TeoMouse/2P2S3B-Converter/README.md

# 2P2S3B-Converter
2 Phase, 2 Switch Bidirectional Buck Boost Converter
