TeoMouse/2P2S3B-Converter/3_ProductionFiles/1_ControllerBoard/BOM/Bill of Materials-F280025_Daughter_Board.xlsx

Line # | Name | Description | Designator | Quantity | Manufacturer | Value | Manufacturer Part No | Manufacturer 1 | Manufacturer Part Number 1
 | C0603 | Capacitor | C1, C6, C7, C8, C10 | 5 |  | 10uF/25V
 | C0402 | Capacitor | C2, C3, C4, C5, C9, C11, C12, C16, C17, C18, C21 | 11 |  | 100nF/50V
 | C0402 | Capacitor | C13 | 1 |  | 10nF/50V
 | C0402 | Capacitor | C14, C15 | 2 |  | 12pF/25V
 | C1206 | Capacitor | C22 | 1 |  | 2.2uF/100V
 | C0805 | Capacitor | C23, C24 | 2 |  | 22uF/25V
 | C0402 | Capacitor | C25, C26, C27, C28 | 4 |  | 1uF/25V
 | C0402 | Capacitor | C29, C30, C31, C32, C33, C34, C35, C36, C37, C38, C39, C40, C41, C42 | 14 |  | 1nF/25V
 | V | LED | D1, D2 | 2 |  |  |  | Wurth Electronics | 150060GS75000
 | 100Ohms |  | FB1, FB2 | 2 |  |  |  | Wurth Electronics | 742792620
 | 74404064680 | Inductor 68 uH 1A Wurth Elektronic | L2 | 1 |  |  |  | Wurth Electronics | 74404064680
 | 2x22_2mm_PCBCon |  | P1 | 1 |  |  |  | Samtec | FTS-122-01-F-D
 | R0402 | Resistor | R1, R2, R3, R4, R5, R6, R7, R8, R9, R10, R11, R13, R15, R16 | 14 |  | 100R
 | R0402 | Resistor | R12, R14 | 2 |  | 33R
 | R0402 | Resistor | R17, R24, R28 | 3 |  | 2.2k
 | R0402 | Resistor | R18, R19, R20, R21, R25, R26, R27, R30 | 8 |  | 10k
 | R0402 | Resistor | R22, R23 | 2 |  | 500R
 | R0402 | Resistor | R29 | 1 |  | 800R
 | R0805 | Resistor | R34 | 1 |  | 0R
 | R0402 | Resistor | R35 | 1 |  | 118k
 | R0402 | Resistor | R36 | 1 |  | 22.1k
 | SW2x2 | Tactile Switches SPST OFF-(ON) Round pushbutton | SW1 | 1 | TE Connectivity / Alcoswitch |  | FSM4JH
 | TMS320F280025C_LQFP48 |  | U1 | 1 |  |  |  | Texas Instruments | F280025CPTSR
 | 1x6 2.54mm St_Con_Fem |  | U2 | 1
 | TPS3702CX33DDCR |  | U3 | 1 |  |  |  | Texas Instruments | TPS3702CX33DDCR
 | LMR51610 |  | U5 | 1 |  |  |  | Texas Instruments | LMR51610XFDBVR
 | REF3030AIDBZR |  | U6 | 1 |  |  |  | Texas Instruments | REF3030AIDBZR
 | AP2112K-3.3TRG1 |  | U7 | 1 |  |  |  | Diodes | AP2112K-3.3TRG1
 | ECS-200-8-30B-CKM | 20MHz crystal oscillator | Y1 | 1 |  |  |  | ECS International | ECS-200-8-30B-CKM
