TeoMouse/2P2S3B-Converter/3_ProductionFiles/2_HBridgeBoard/BOM/Bill of Materials-HBridges_PB_V2.xlsx

Line # | Name | Description | Designator | Quantity | Manufacturer 1 | Manufacturer Part Number 1 | Manufacturer Lifecycle 1 | Supplier 1 | Supplier Part Number 1
 | C1206 | Capacitor | C2_1, C2_2, C3_1, C3_2 | 4 | Kyocera AVX | 12061C225KAT2A | Volume Production | Mouser | 581-12061C225KAT2A
 | C0603 | Capacitor | C4, C7 | 2
 | C0603 | Capacitor | C5, C6 | 2
 | C0402 | Capacitor | C8, C10, C11 | 3
 | C0402 | Capacitor | C9, C12, C13, C14, C15 | 5
 | Schottky | Schottky Diode | D5, D6 | 2 | ON Semiconductor / Fairchild | S110FA | Not Recommended for New Design | Mouser | 512-S110FA
 | Inductor 0603 | Magnetic-Core Inductor | L1, L2 | 2 | TDK | MLZ1608N100LTD25 | Volume Production | Mouser | 810-MLZ1608N100LTD25
 | 2Ph_HB_DB |  | P1 | 1
 | R0805 | Resistor | R1_1, R1_2, R2_1, R2_2, R3_1, R3_2, R4_1, R4_2 | 8
 | R0402 | Resistor | R5_1, R5_2, R6_1, R6_2, R11_1, R11_2, R12_1, R12_2, R17, R18, R19, R20 | 12
 | R0603 | Resistor | R7, R8 | 2 | Panasonic | ERT-J1VG103FM | Volume Production | Mouser | 667-ERT-J1VG103FM
 | R0603 | Resistor | R13, R14 | 2
 | R0402 | Resistor | R15, R16 | 2
 | TPH4R10ANL-L1Q | MOSFET N-Channel | U1_1, U1_2, U2_1, U2_2, U3_1, U3_2, U4_1, U4_2 | 8 | Toshiba | TPH4R10ANL,L1Q | Unknown | Mouser | 757-TPH4R10ANLL1Q
 | UCC21225 |  | U5, U6 | 2 | Texas Instruments | UCC21225ANPLR | Volume Production | Mouser | 595-UCC21225ANPLR
