TeoMouse/2P2S3B-Converter/3_ProductionFiles/3_MainBoard/BOM/Bill of Materials-2Ph_BuckBoost_Main.xlsx

Line # | Name | Description | Designator | Quantity | Manufacturer 1 | Manufacturer Part Number 1 | Manufacturer Lifecycle 1 | Supplier 1 | Supplier Part Number 1
 | 200uF/63V |  | C1 | 1
 | C1206 | Capacitor | C2, C3, C7, C8, C9, C10, C11, C12, C13, C14, C15, C16, C17, C18, C19, C20, C21, C22, C23, C24 | 20 | Kyocera AVX | 12061C225KAT2A | Volume Production | Mouser | 581-12061C225KAT2A
 | C0603 | Capacitor | C4 | 1
 | C0402 | Capacitor | C5 | 1
 | Cap_Bank 600uF 35V | Polarized Capacitor SMD | C6 | 1
 | C0402 | Capacitor | C25 | 1
 | C0402 | Capacitor | C26, C27, C28, C35_1, C35_2, C36_1, C36_2, C37, C38 | 9
 | C0805 | Capacitor | C29 | 1
 | C0805 | Capacitor | C30, C31 | 2
 | C0402 | Capacitor | C32, C33 | 2
 | C0402 | Capacitor | C34_1, C34_2 | 2
 | Schottky | Schottky Diode | D1, D2, D3 | 3 | ON Semiconductor / Fairchild | S110FA | Not Recommended for New Design | Mouser | 512-S110FA
 | WurthConnector_M3_FEM |  | J1, J2, J3, J4 | 4 | Wurth Electronics | 74650073R | Unknown | Mouser | 710-74650073R
 | Inductor TDK | Magnetic-Core Inductor | L1, L2 | 2 | TDK | B82559A0303A024 | Volume Production | Mouser | 871-B82559A0303A024
 | 74404064680 | Inductor 68 uH 1A Wurth Elektronic | L3 | 1 | Wurth Electronics | 74404064680 | Volume Production | Mouser | 710-74404064680
 | F280025_DB_Connector |  | P1 | 1
 | 2Ph_HB_DB |  | P2 | 1
 | 1x2 2.54mm Straight Con |  | P3 | 1
 | PMV450ENEAR | MOSFET (N-Channel) | Q1 | 1 | Nexperia | PMV450ENEAR | Volume Production | Mouser | 771-PMV450ENEAR
 | R0805 | Resistor | R1 | 1
 | R0603 | Resistor | R2 | 1
 | R0402 | Resistor | R3 | 1
 | R0402 | Resistor | R4, R10 | 2
 | R0603 | Resistor | R5, R6, R8, R9 | 4
 | R0402 | Resistor | R7, R14_1, R14_2 | 3
 | R0402 | Resistor | R11 | 1
 | R0402 | Resistor | R12 | 1
 | Rshunt | Resistor | R13_1, R13_2 | 2 | Bourns | CSS2H-2512R-1L00FE | Unknown | Mouser | 652-CSS2H2512R1L00FE
 | R0402 | Resistor | R15, R16, R17, R18 | 4
 | TLV9061 |  | U1 | 1 | Texas Instruments | TLV9061SQDBVRQ1 | Volume Production | Mouser | 595-TLV9061SQDBVRQ1
 | LMR51610 |  | U2 | 1 | Texas Instruments | LMR51610XFDBVR | Volume Production | Mouser | 595-LMR51610XFDBVR
 | ISL21010CFH315Z-TK |  | U3 | 1 | Intersil | ISL21010CFH315Z-TK | Volume Production | Mouser | 968-ISL21010CFH315ZT
 | INA296B3 |  | U4_1, U4_2 | 2 | Texas Instruments | INA296B4IDDFR | Volume Production | Mouser | 595-INA296B4IDDFR
