TeoMouse/2P2S3B-Converter/3_ProductionFiles/4_InputCapBoard/BOM/Bill of Materials-Cap_Board.xlsx

Line # | Name | Description | Designator | Quantity | Manufacturer 1 | Manufacturer Part Number 1 | Supplier 1 | Supplier Part Number 1
 | Cap_Pol 100uF 63V | Polarized Capacitor SMD | C1, C2 | 2 | Panasonic | EEE-FK1J101P | Mouser | 667-EEE-FK1J101P
 | 1x4 2.54mm St_Con_SMD |  | U1 | 1 | Amphenol Communications Solutions | 68000-204HLF | Mouser | 649-68000-204HLF
