TeoMouse/2P2S3B-Converter/3_ProductionFiles/5_OutputCapBoard/BOM/Bill of Materials-OutputCapBoard.xlsx

Line # | Name | Description | Designator | Quantity | Manufacturer 1 | Manufacturer Part Number 1 | Supplier 1 | Supplier Part Number 1
 | Cap_Pol 100uF 35V | Polarized Capacitor SMD | C1, C2, C3, C4, C5, C6 | 6 | Wurth Electronics | 865080545012 | Mouser | 710-865080545012
 | 1x3 2.54mm St_con |  | P1, P2 | 2 | Molex | 22-28-8032 | Mouser | 538-22-28-8032
