TeoMouse/2P2S3B-Converter/3_ProductionFiles/2_HBridgeBoard/ExportSTEP/HBridge_PCB.step

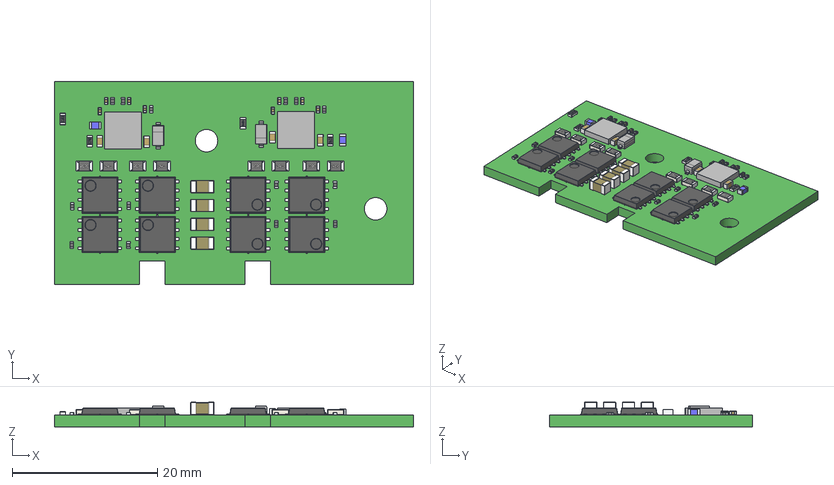
[picture p1: CAD file, 2025-03-23]
3_ProductionFiles/2_HBridgeBoard/ExportSTEP/HBridge_PCB.step
49.5 x 28.0 x 3.40 mm
Pin1Body x 4
Pin2Body x 4
CeramicBody x 4
CoatingBody x 4
Text1Body x 4
Text2Body x 4
Text3Body x 4
Text4Body x 4
User_Library-Vhip_cap_1206 x 4
Extruded x 2
TPH4R10ANL,L1Q x 8
term1 x 16
term2 x 16
User_Library-RES_2013-0805 x 8
CircuitWorks-SOD123_RGB8421504 x 2
User_Library-CAPC1608X09 x 4
