TeoMouse/2P2S3B-Converter/3_ProductionFiles/4_InputCapBoard/ExportSTEP/CapBoard.step

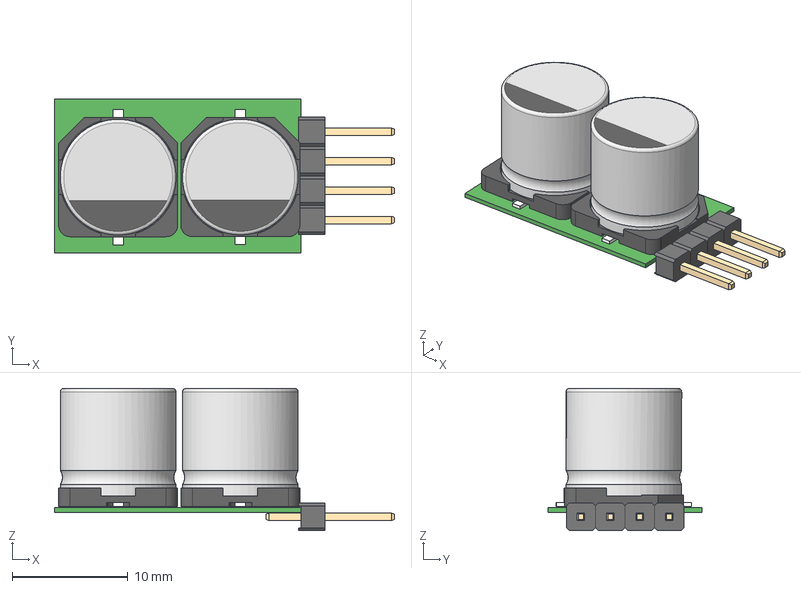
[picture p2: CAD file, 2025-03-23]
3_ProductionFiles/4_InputCapBoard/ExportSTEP/CapBoard.step
29.4 x 13.3 x 12.3 mm
1_Male_Pin_2.54_mm x 4
\X2\6A196E9654C130B130FC30B903A6\X0\10x9.3L_SIDE_CODE_G x 2
\X2\6A196E9654C15EA7724803A6\X0\10_SIZE_CODE_G x 2
\X2\6A196E9654C130EA30FC30C97DDA03A6\X0\10_SIZE_CODE_G x 4
