TeoMouse/2P2S3B-Converter/3_ProductionFiles/5_OutputCapBoard/ExportSTEP/CapsPCB.step

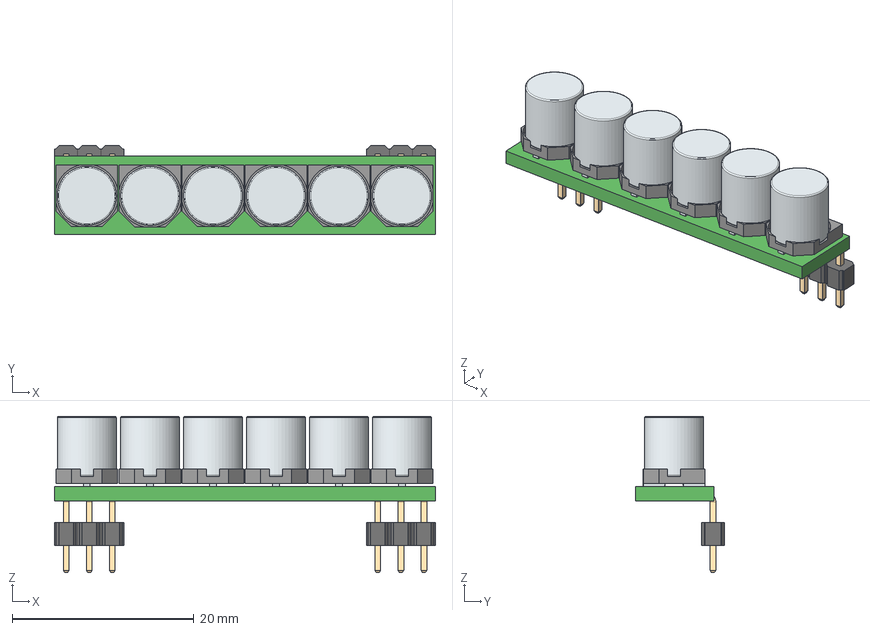
[picture p3: CAD file, 2025-03-23]
3_ProductionFiles/5_OutputCapBoard/ExportSTEP/CapsPCB.step
41.9 x 9.75 x 17.2 mm
DS1022-1x7RUF11_(1) x 2
Base x 6
Pin1Fillet x 6
Pin2Fillet x 6
