TeoMouse/2P2S3B-Converter/3_ProductionFiles/1_ControllerBoard/ExportSTEP/F280025_DB.step

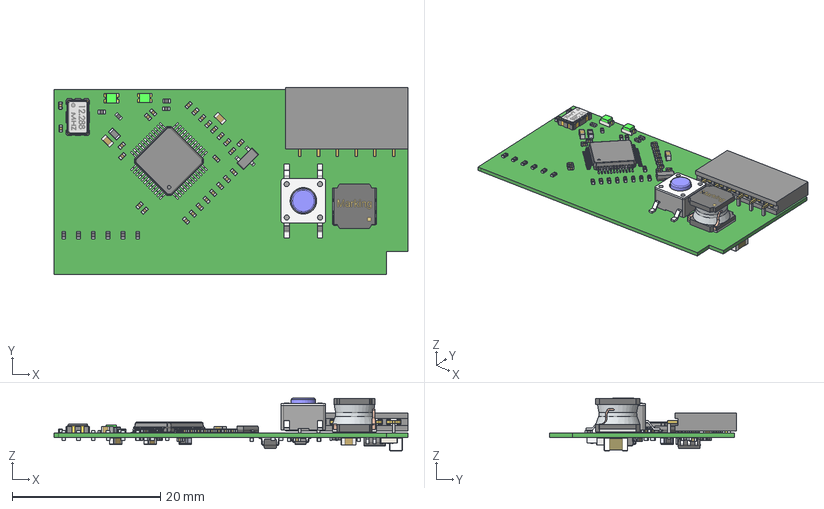
[picture p4: CAD file, 2025-03-23]
3_ProductionFiles/1_ControllerBoard/ExportSTEP/F280025_DB.step
47.8 x 25.3 x 7.09 mm
term1 x 32
term2 x 32
OSC5032
sot23-5_p0-95_l3-0_w1-7
DBZ0003A_2
DBZ0003A_1 x 3
SOT23-6
DDC0006A_2
DDC0006A_1 x 6
Pitch_x_8
Plastic_x_8
BODY_VBH48A
LEAD_VBH48A x 48
LL3301_SMT
TopPlate
Plunger
Pins
User_Library-RES_2013-0805
housing
contact x 2
spule
Glue
ferrite_bead_0603 x 2
everlight-17-21-0805LED-GREEN x 2
User_Library-CAPC2013X10 x 2
User_Library-Vhip_cap_1206
User_Library-CAPC1608X09 x 5
