TeoMouse/2P2S3B-Converter/(list of files, cad)

Other CAD files:
1_F280025_Firmware/1_BuckModeFirmware/CPU1_FLASH/main (1).obj
1_F280025_Firmware/1_BuckModeFirmware/CPU1_RAM/main.obj
1_F280025_Firmware/1_BuckModeFirmware/CPU1_RAM/control.obj
1_F280025_Firmware/1_BuckModeFirmware/CPU1_RAM/pwm.obj
1_F280025_Firmware/1_BuckModeFirmware/CPU1_FLASH/gpio_ex1_setup.obj
1_F280025_Firmware/1_BuckModeFirmware/CPU1_FLASH/adc.obj
1_F280025_Firmware/1_BuckModeFirmware/CPU1_RAM/adc.obj
1_F280025_Firmware/1_BuckModeFirmware/CPU1_FLASH/control.obj
1_F280025_Firmware/1_BuckModeFirmware/CPU1_FLASH/pwm.obj
1_F280025_Firmware/1_BuckModeFirmware/CPU1_FLASH/f28002x_globalvariabledefs.obj
1_F280025_Firmware/1_BuckModeFirmware/CPU1_RAM/f28002x_piectrl.obj
1_F280025_Firmware/1_BuckModeFirmware/CPU1_RAM/f28002x_epwm.obj
1_F280025_Firmware/1_BuckModeFirmware/CPU1_FLASH/f28002x_defaultisr.obj
1_F280025_Firmware/1_BuckModeFirmware/CPU1_FLASH/f28002x_sysctrl (1).obj
1_F280025_Firmware/1_BuckModeFirmware/CPU1_FLASH/f28002x_codestartbranch.obj
1_F280025_Firmware/1_BuckModeFirmware/CPU1_FLASH/f28002x_cputimers.obj
1_F280025_Firmware/1_BuckModeFirmware/CPU1_FLASH/f28002x_epwm.obj
1_F280025_Firmware/1_BuckModeFirmware/CPU1_FLASH/f28002x_gpio.obj
1_F280025_Firmware/1_BuckModeFirmware/CPU1_FLASH/f28002x_piectrl.obj
1_F280025_Firmware/1_BuckModeFirmware/CPU1_FLASH/f28002x_pievect.obj
1_F280025_Firmware/1_BuckModeFirmware/CPU1_FLASH/f28002x_usdelay.obj
1_F280025_Firmware/1_BuckModeFirmware/CPU1_RAM/adc (1).obj
1_F280025_Firmware/1_BuckModeFirmware/CPU1_RAM/adc (2).obj
1_F280025_Firmware/1_BuckModeFirmware/CPU1_RAM/control (2).obj
1_F280025_Firmware/1_BuckModeFirmware/CPU1_RAM/f28002x_codestartbranch.obj
1_F280025_Firmware/1_BuckModeFirmware/CPU1_RAM/f28002x_cputimers.obj
1_F280025_Firmware/1_BuckModeFirmware/CPU1_RAM/f28002x_defaultisr.obj
1_F280025_Firmware/1_BuckModeFirmware/CPU1_RAM/f28002x_globalvariabledefs.obj
1_F280025_Firmware/1_BuckModeFirmware/CPU1_RAM/f28002x_gpio.obj
1_F280025_Firmware/1_BuckModeFirmware/CPU1_RAM/f28002x_pievect.obj
1_F280025_Firmware/1_BuckModeFirmware/CPU1_RAM/f28002x_sysctrl.obj
1_F280025_Firmware/1_BuckModeFirmware/CPU1_RAM/f28002x_usdelay.obj
1_F280025_Firmware/1_BuckModeFirmware/CPU1_RAM/main (1).obj
1_F280025_Firmware/1_BuckModeFirmware/CPU1_RAM/pwm (2).obj
