TeoMouse/2P2S3B-Converter/2_Schematic_Documents/3_MainBoard/Schematics.PDF

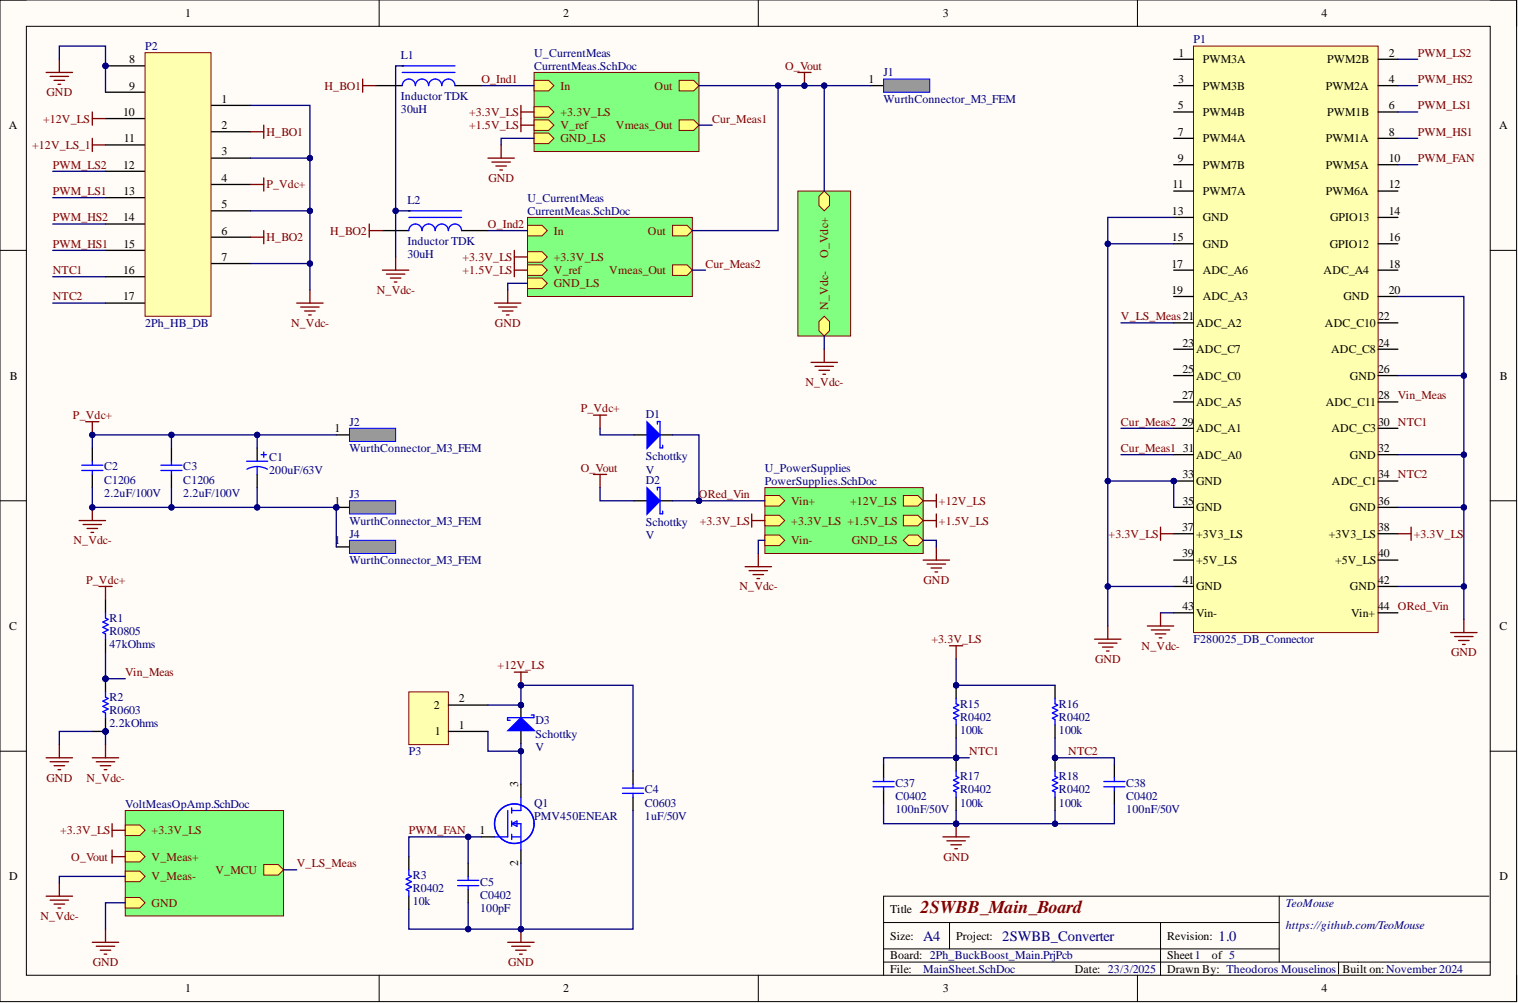
[picture p5: page 1]

4 3 | | 4 4 | ORed _ Vi n

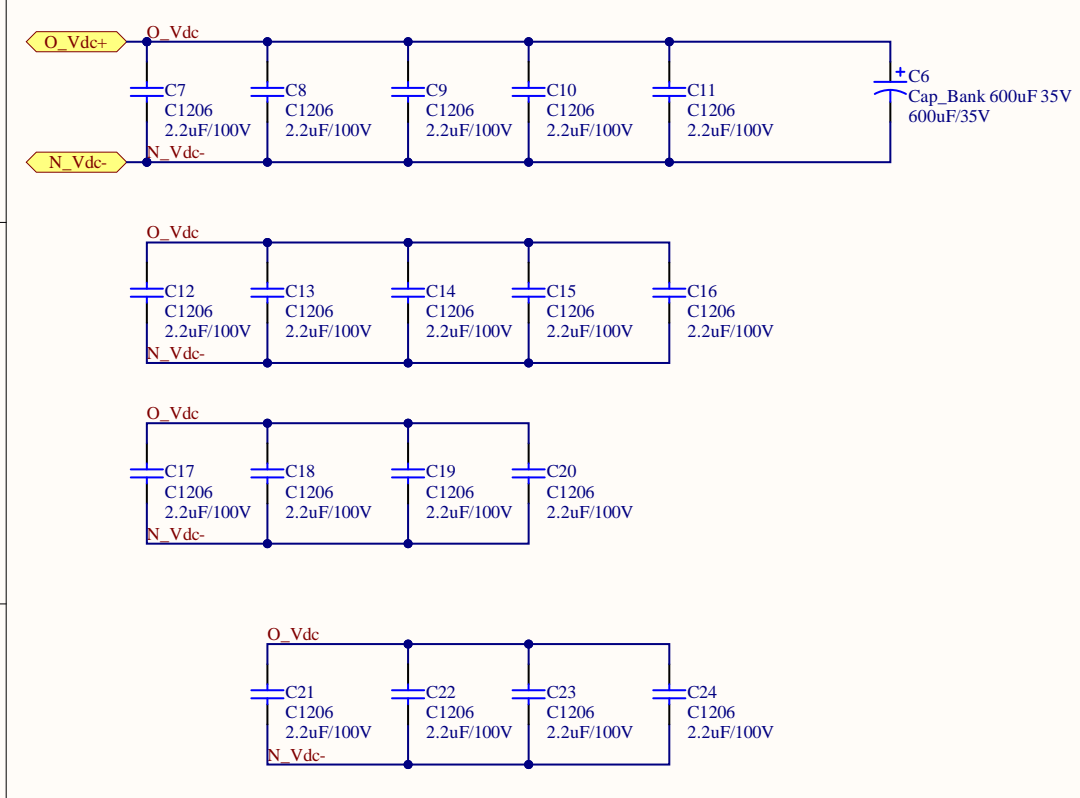
[picture p6: page 2]

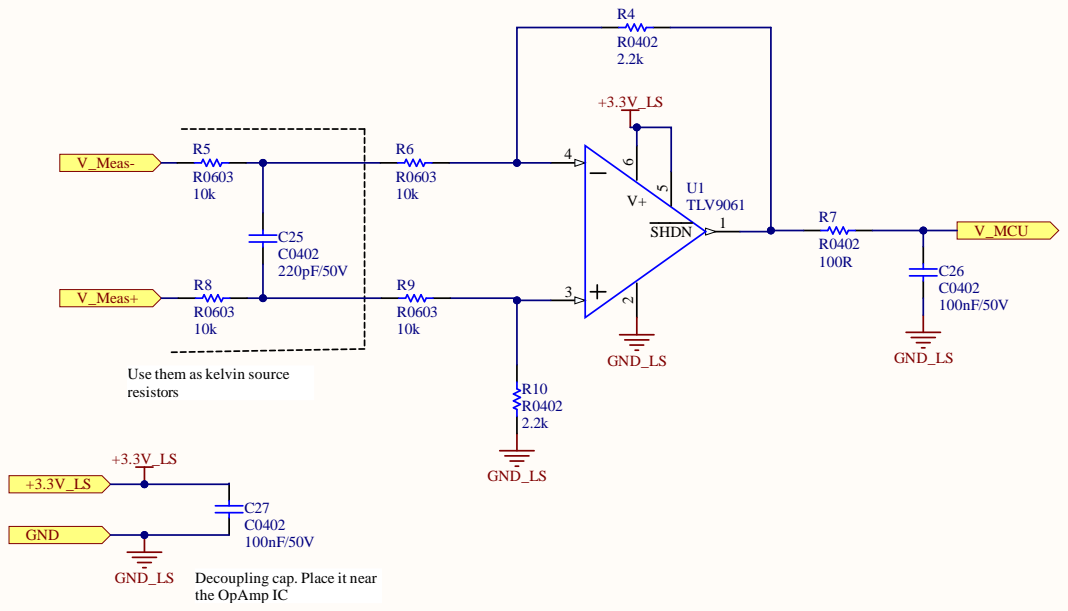
[picture p7: page 3]

Use them as kelvin source
resistors

Decoupling cap. Place it near
the OpAmp IC

https://github.com/TeoMouse

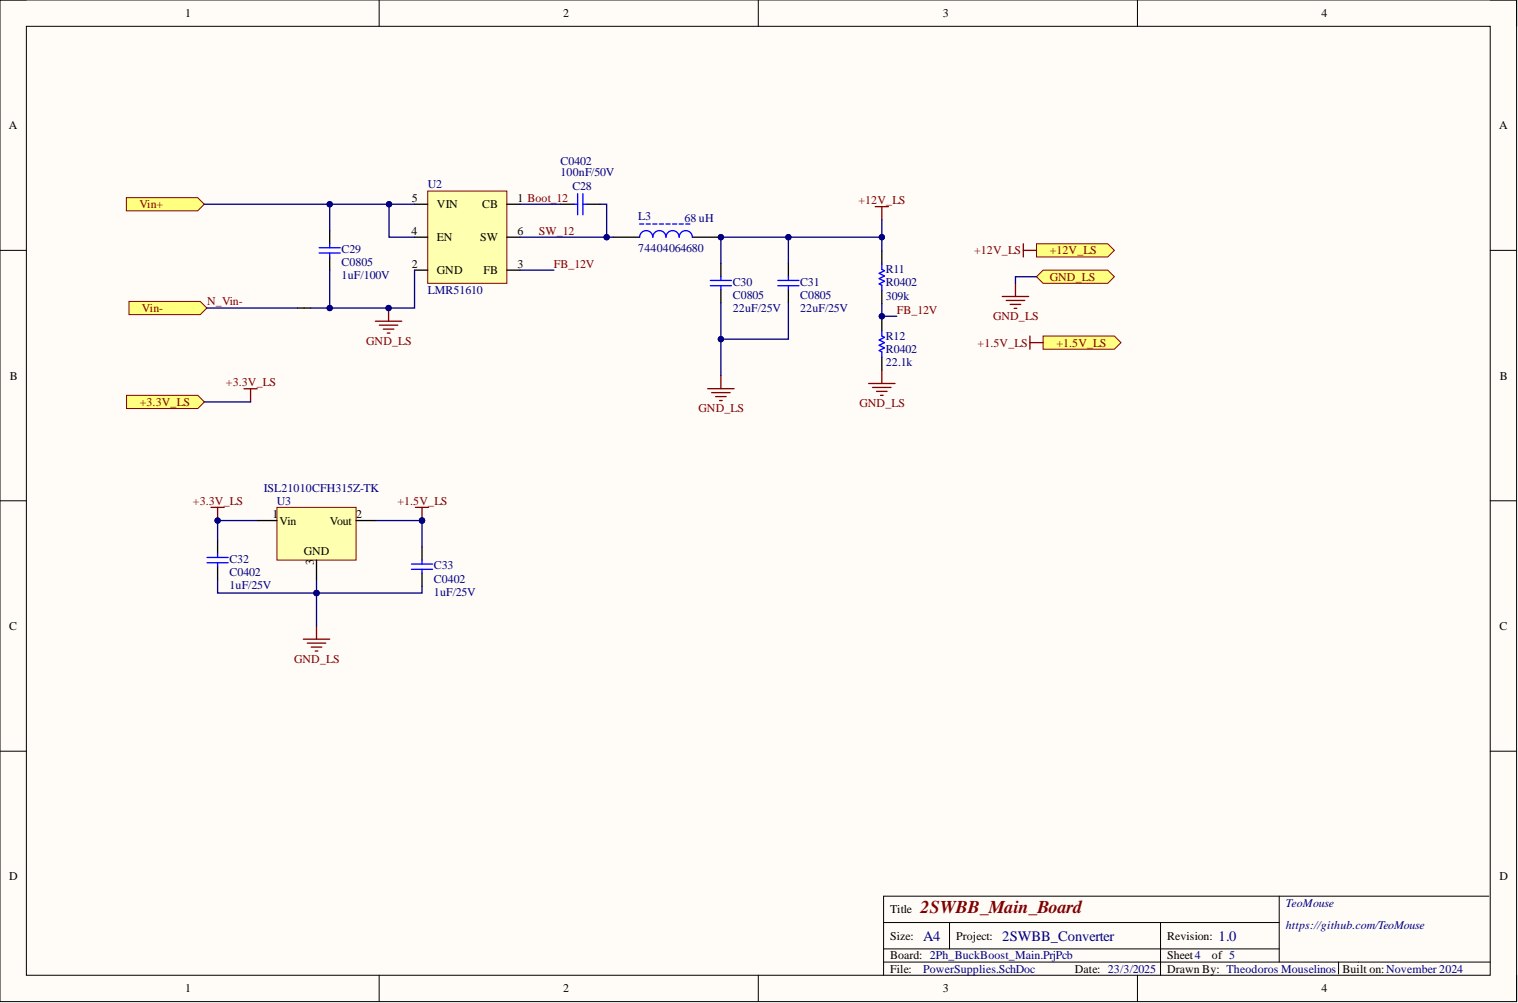
[picture p8: page 4]

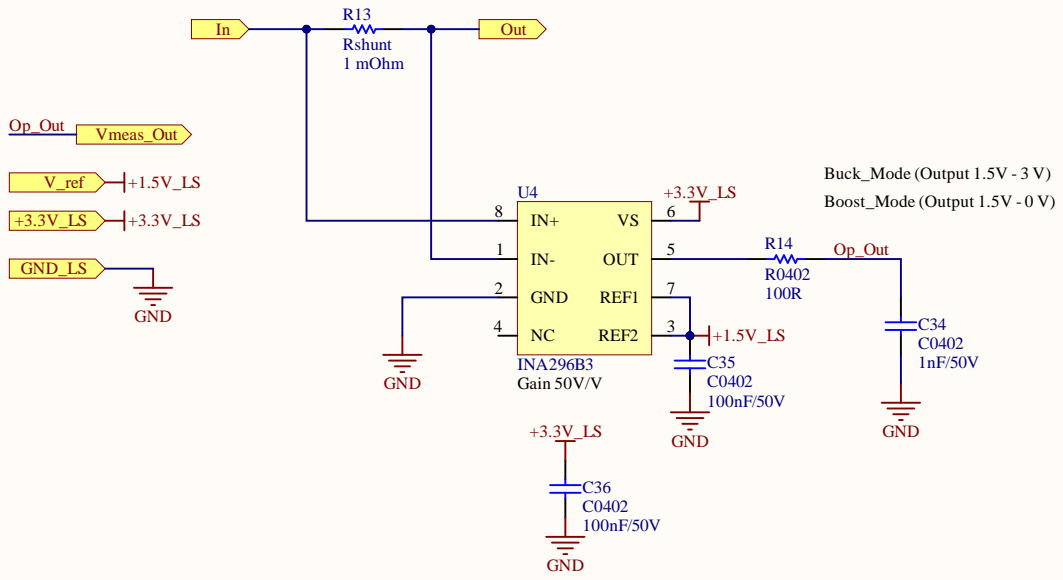
[picture p9: page 5]
