TeoMouse/2P2S3B-Converter/2_Schematic_Documents/1_ControllerBoard/PCB_Layers.PDF

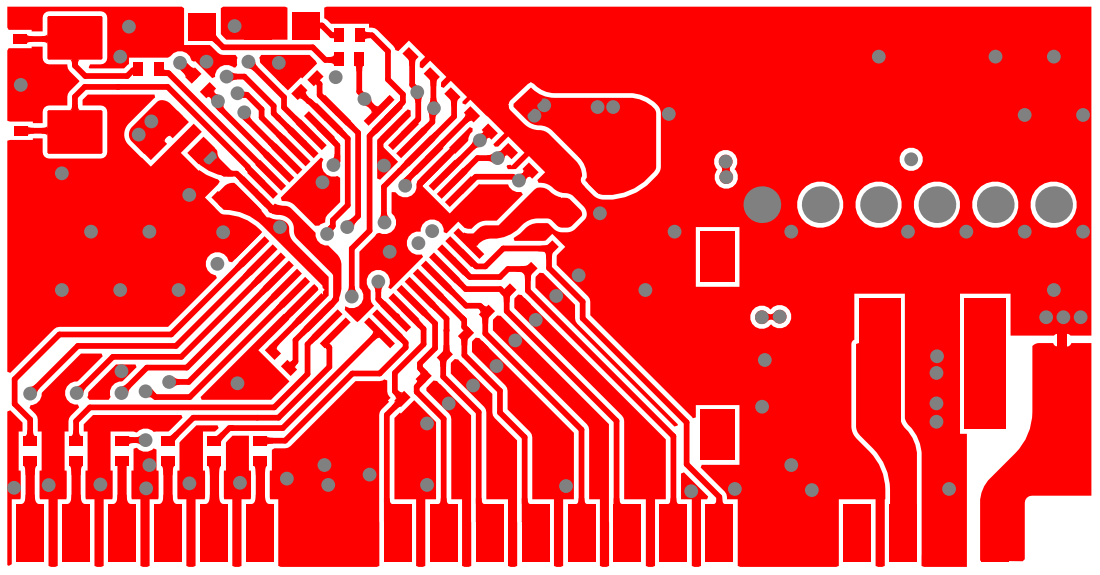
[picture p10: page 1]

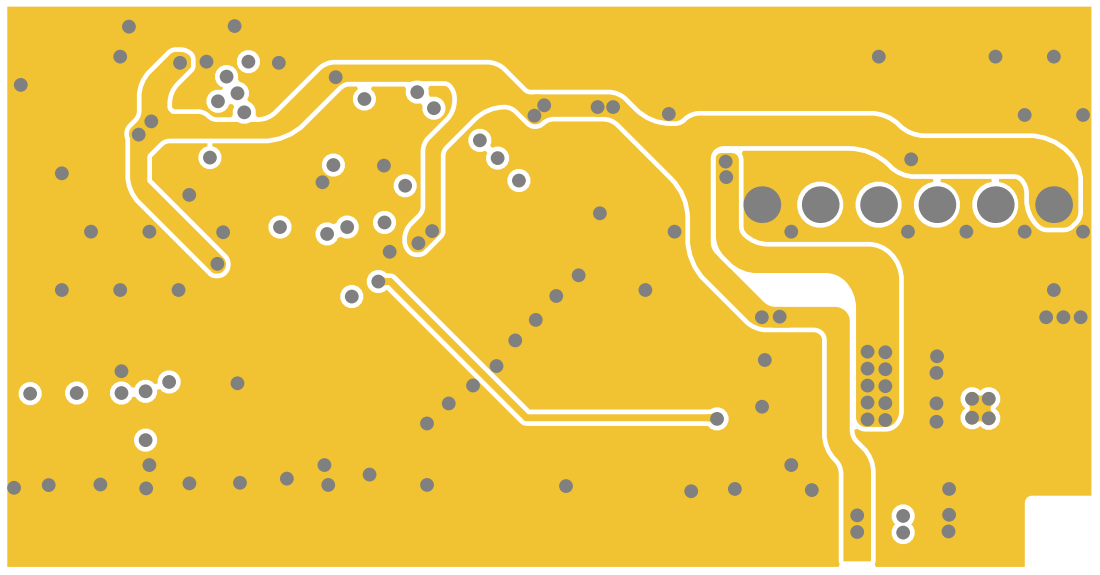
[picture p11: page 2]

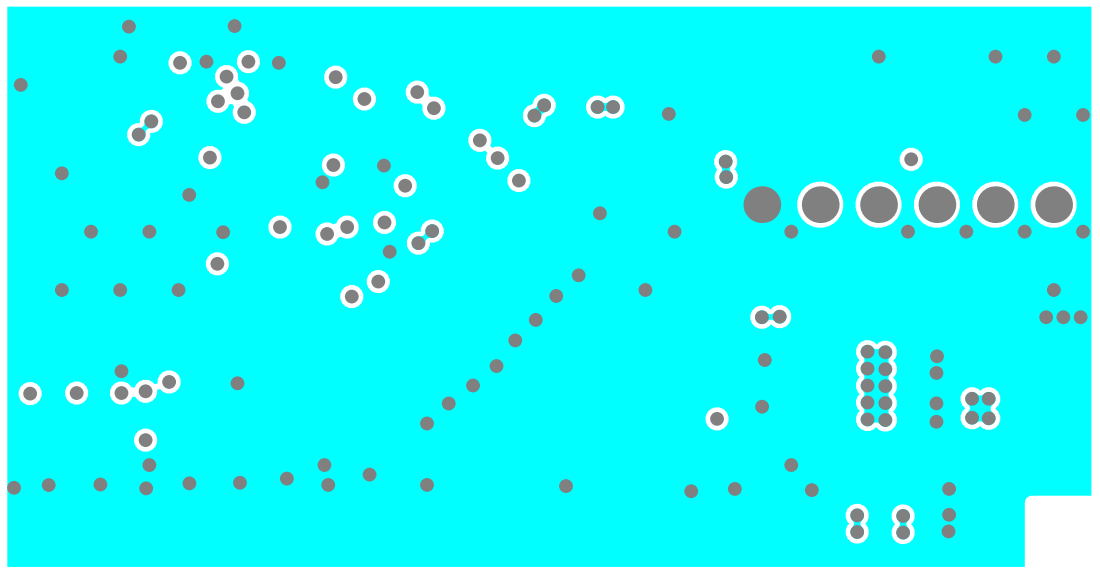
[picture p12: page 3]

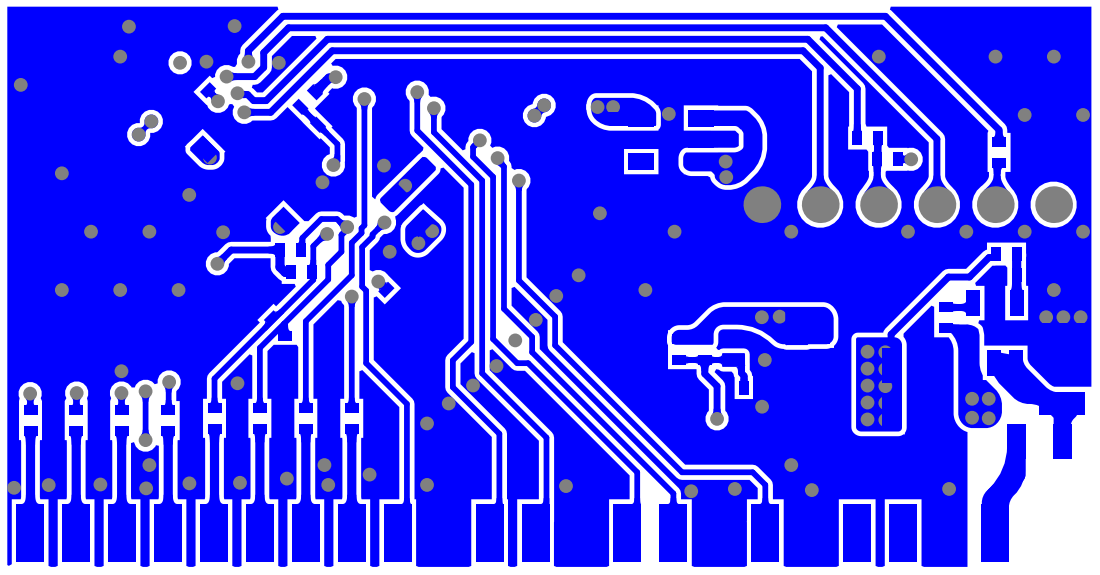
[picture p13: page 4]
