TeoMouse/2P2S3B-Converter/2_Schematic_Documents/1_ControllerBoard/Schematics.PDF

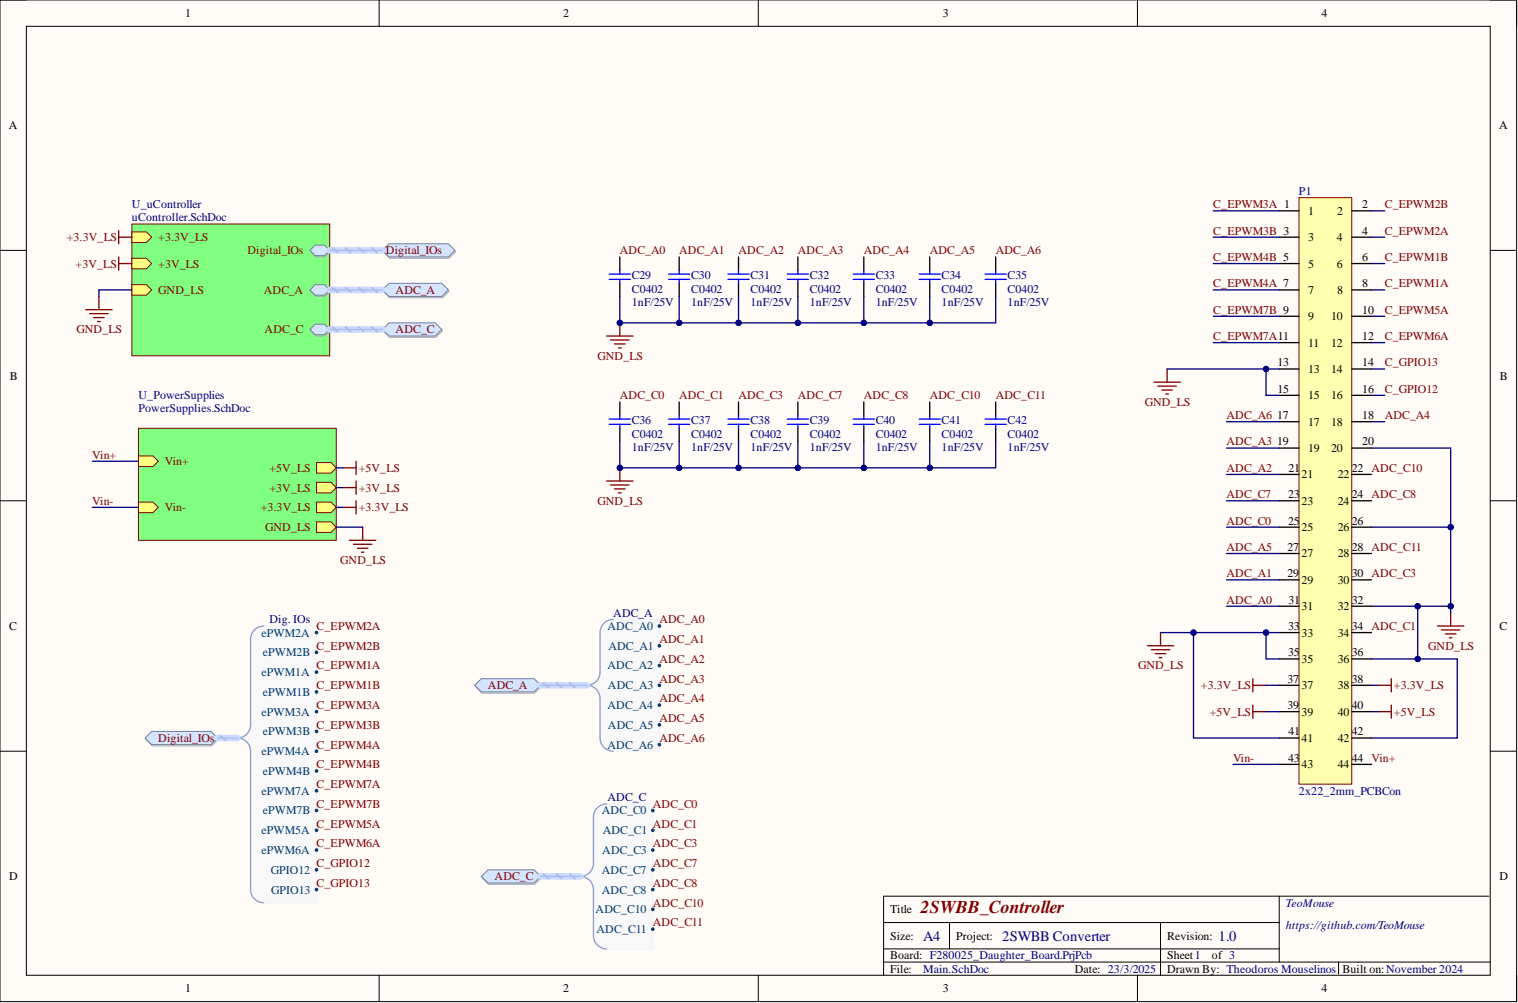
[picture p14: page 1]

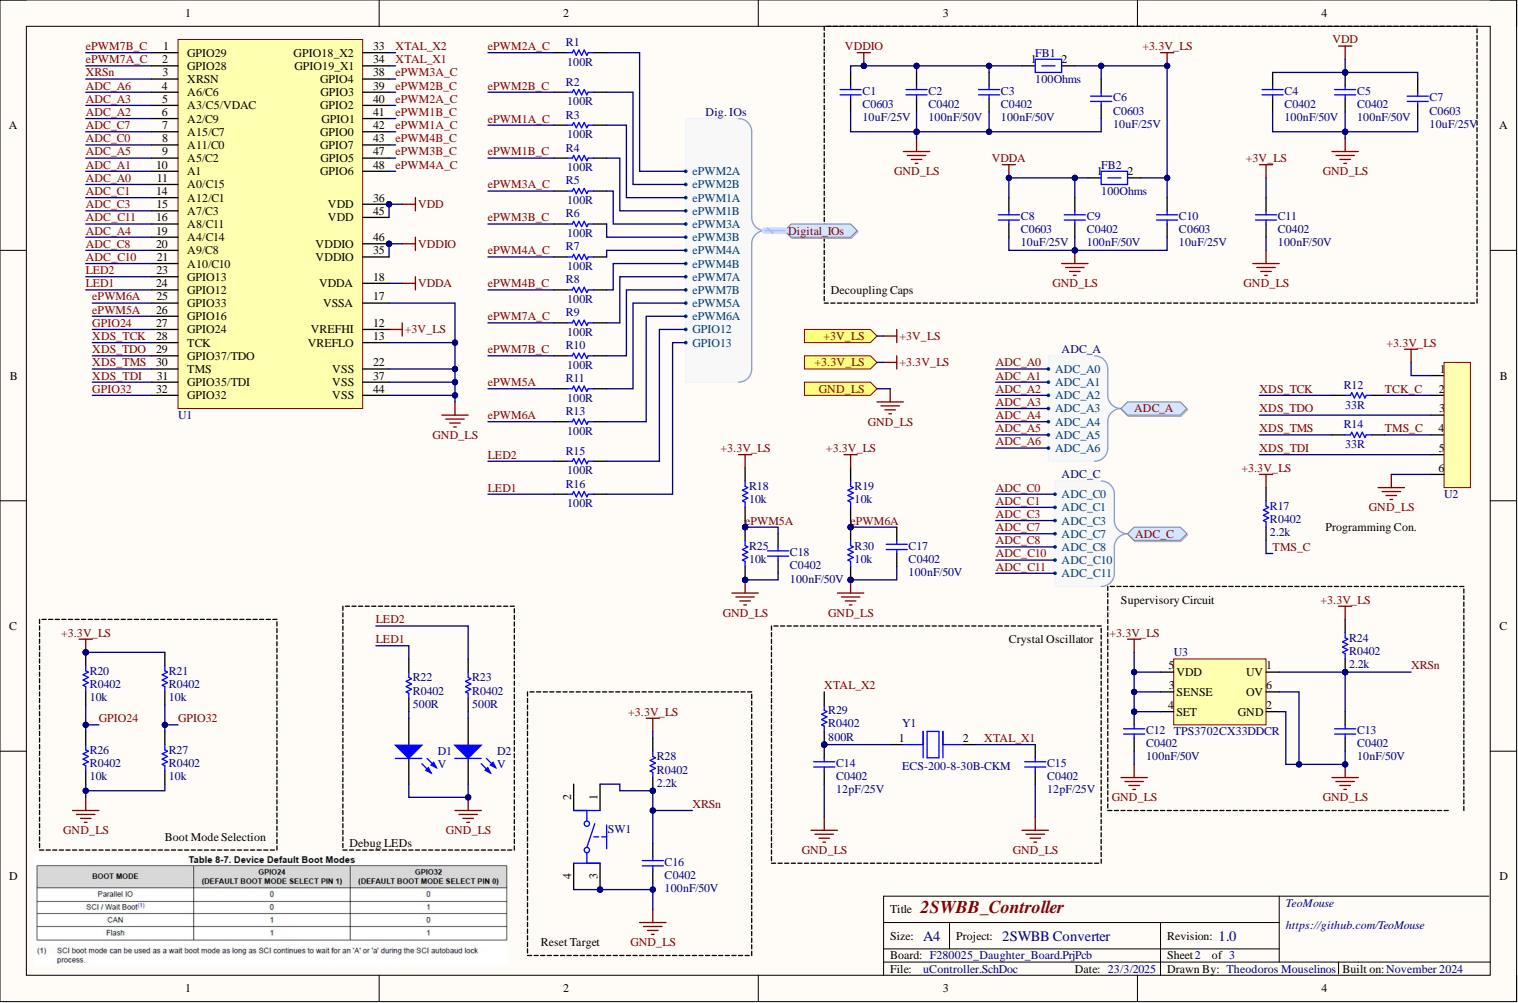
[picture p15: page 2]

2 2
3 7

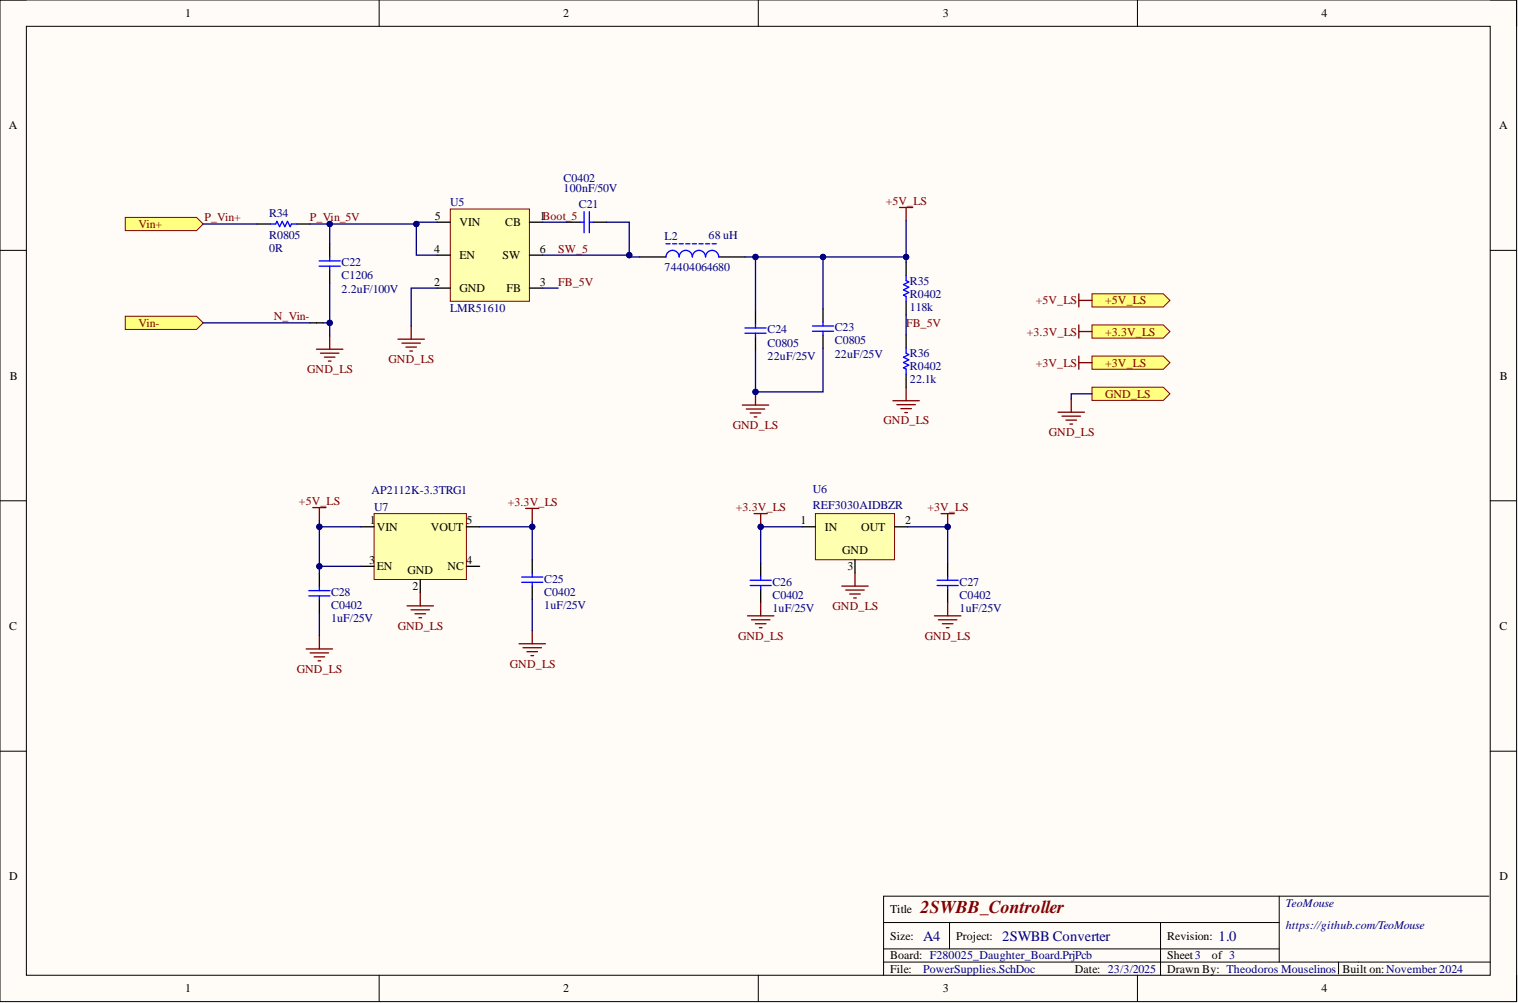
[picture p16: page 3]

https://github.com/TeoMouse
