TeoMouse/2P2S3B-Converter/2_Schematic_Documents/2_HBridgeBoard/PCB_Layers.PDF

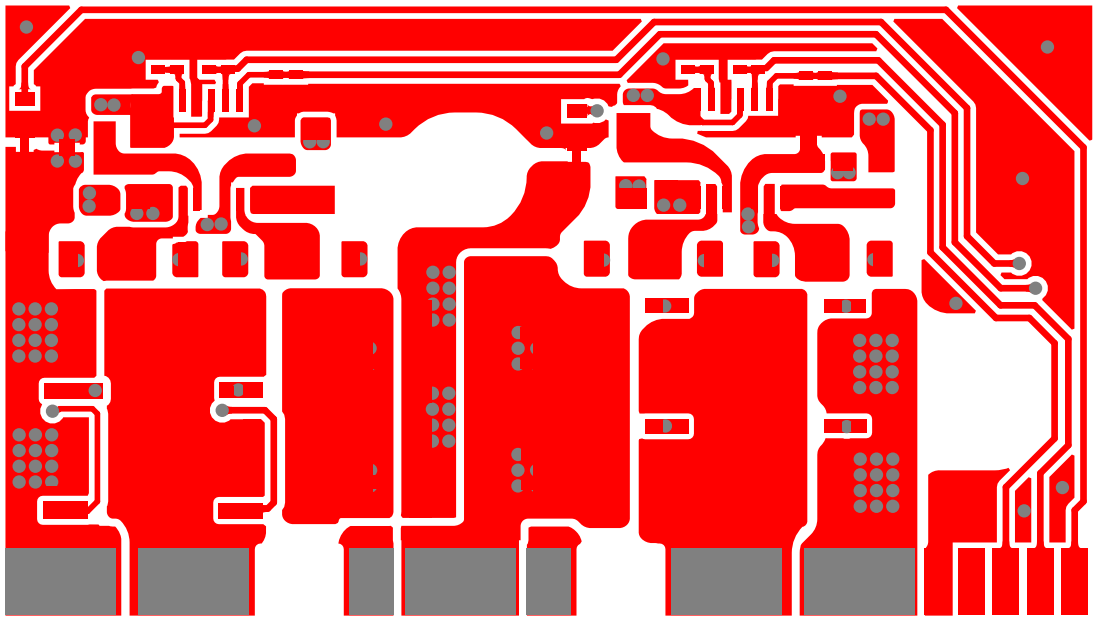
[picture p17: page 1]

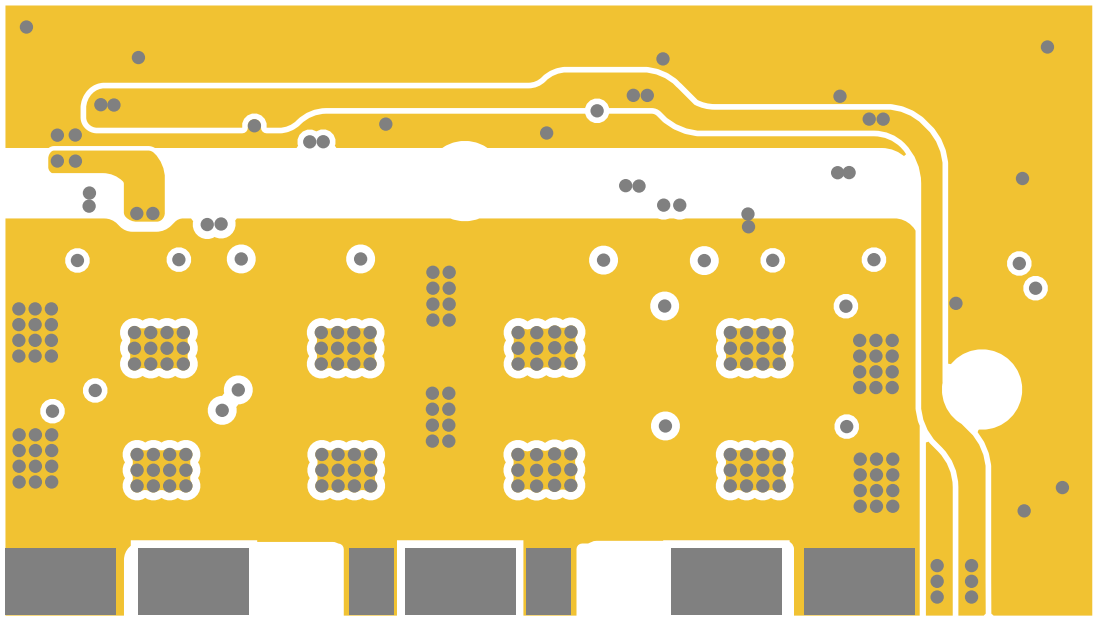
[picture p18: page 2]

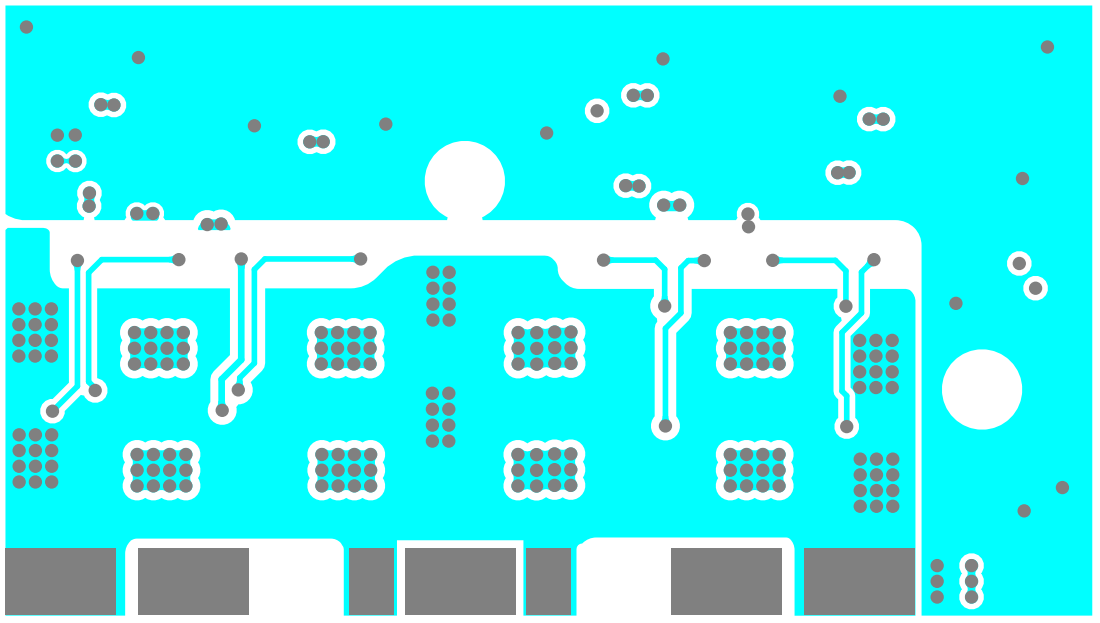
[picture p19: page 3]

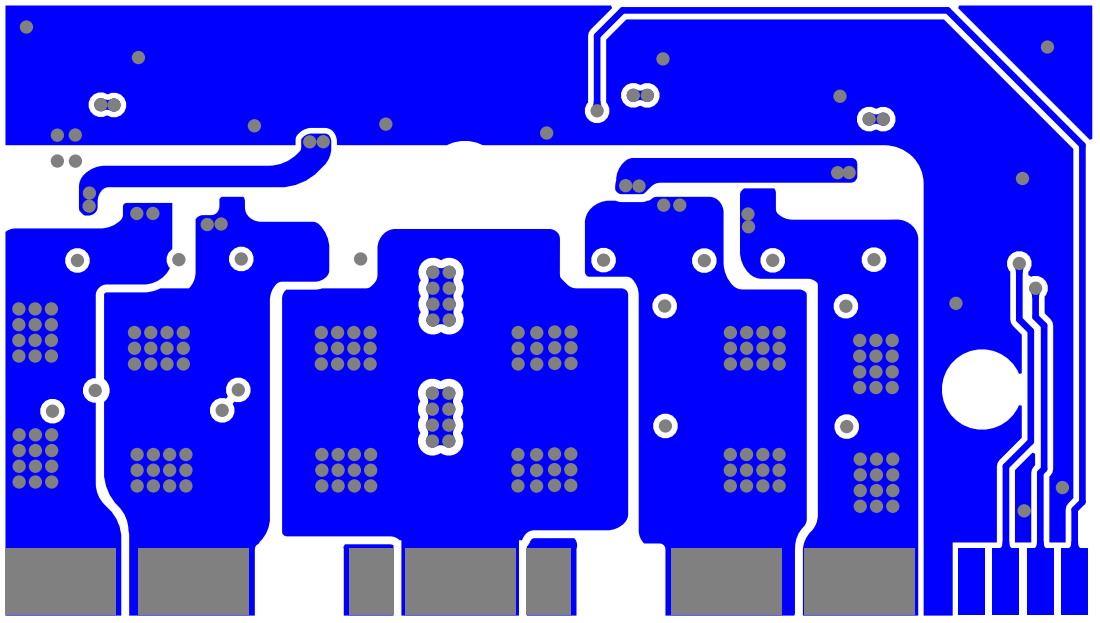
[picture p20: page 4]
