TeoMouse/2P2S3B-Converter/2_Schematic_Documents/2_HBridgeBoard/Schematics.PDF

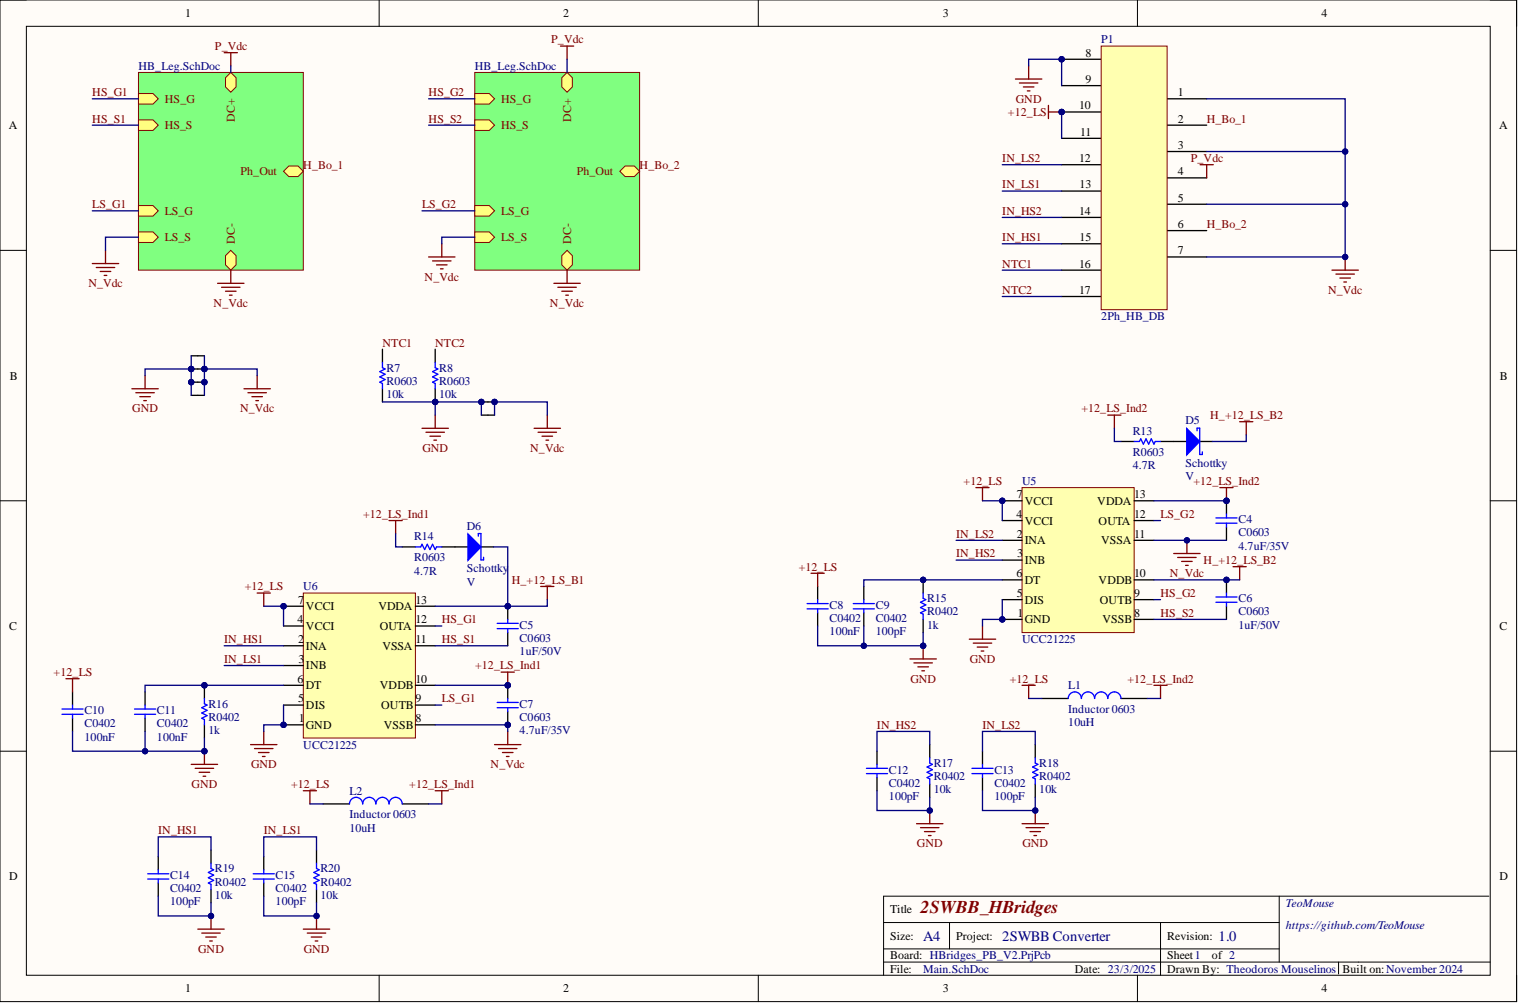
[picture p21: page 1]

https://github.com/TeoMouse

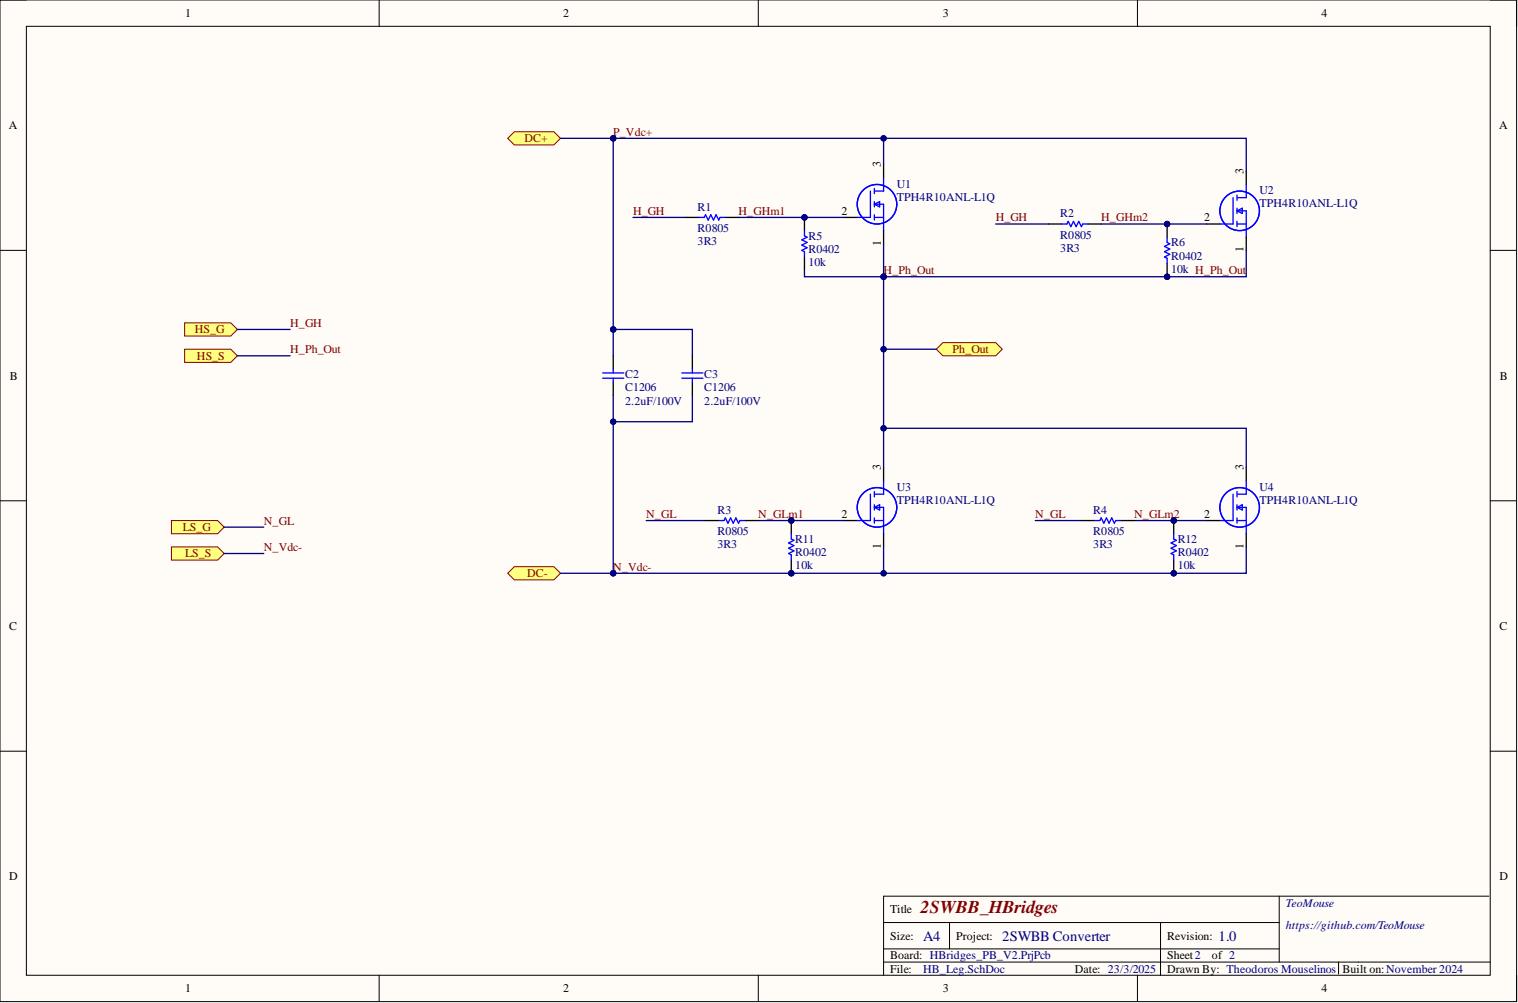
[picture p22: page 2]

https://github.com/TeoMouse
