TeoMouse/2P2S3B-Converter/2_Schematic_Documents/3_MainBoard/PCB_Layers.PDF

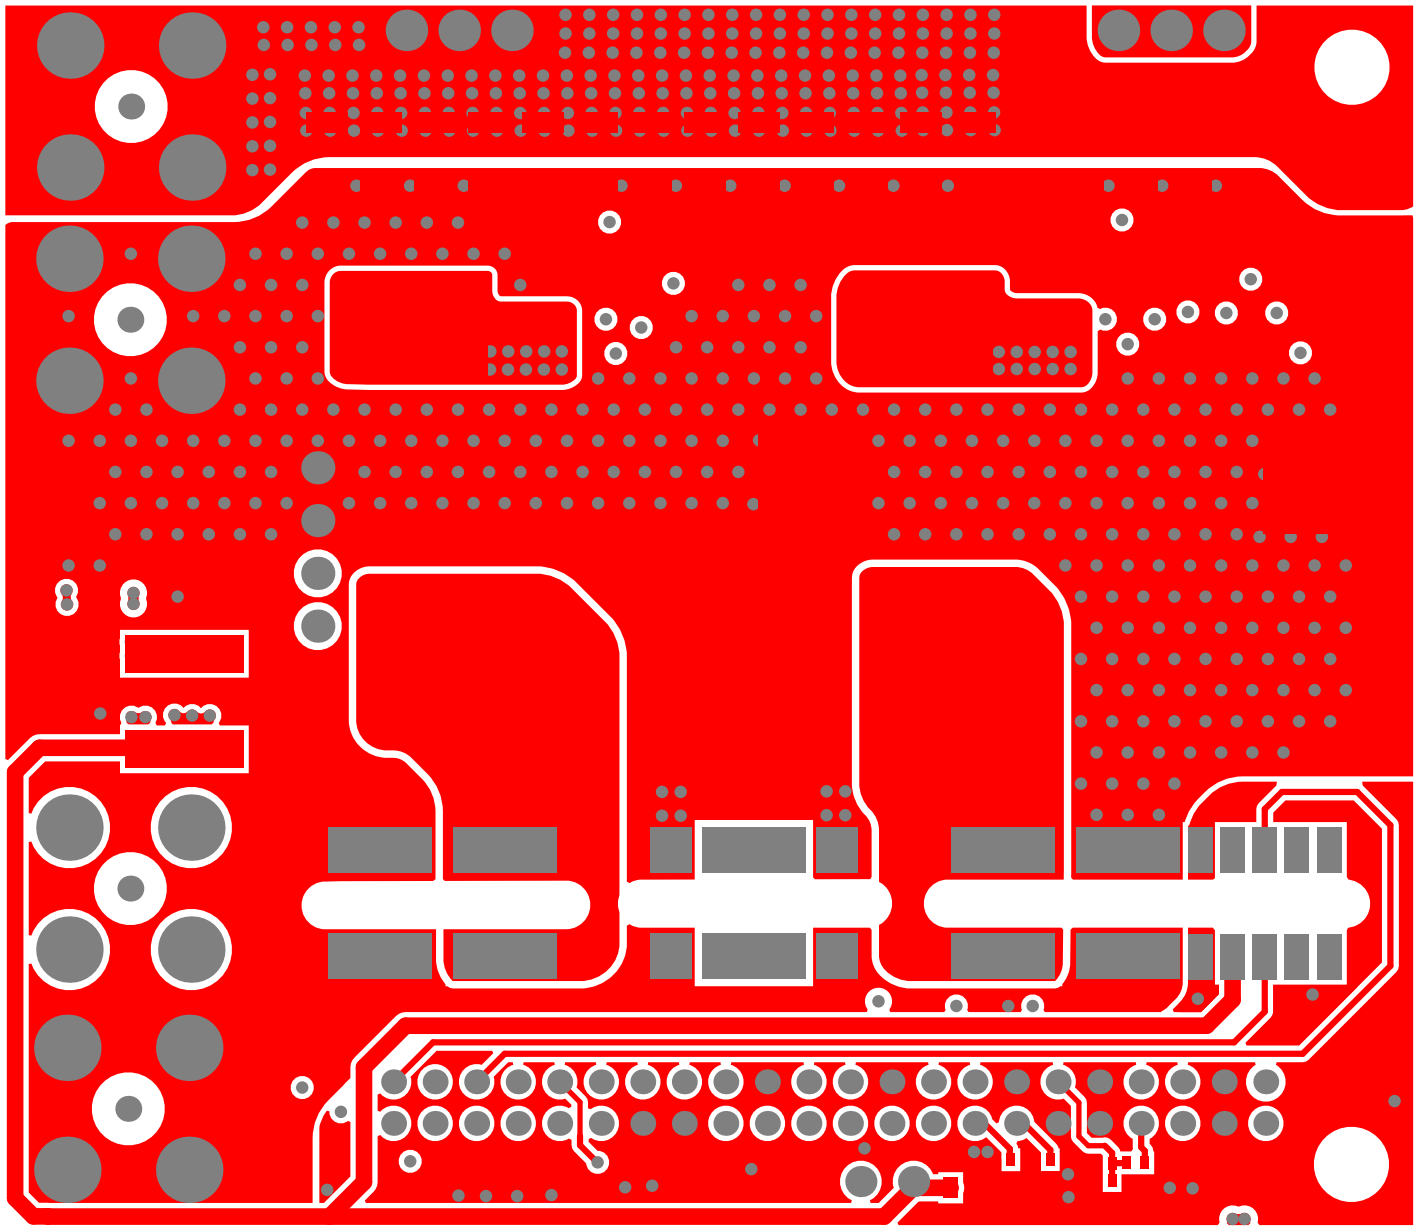
[picture p23: page 1]

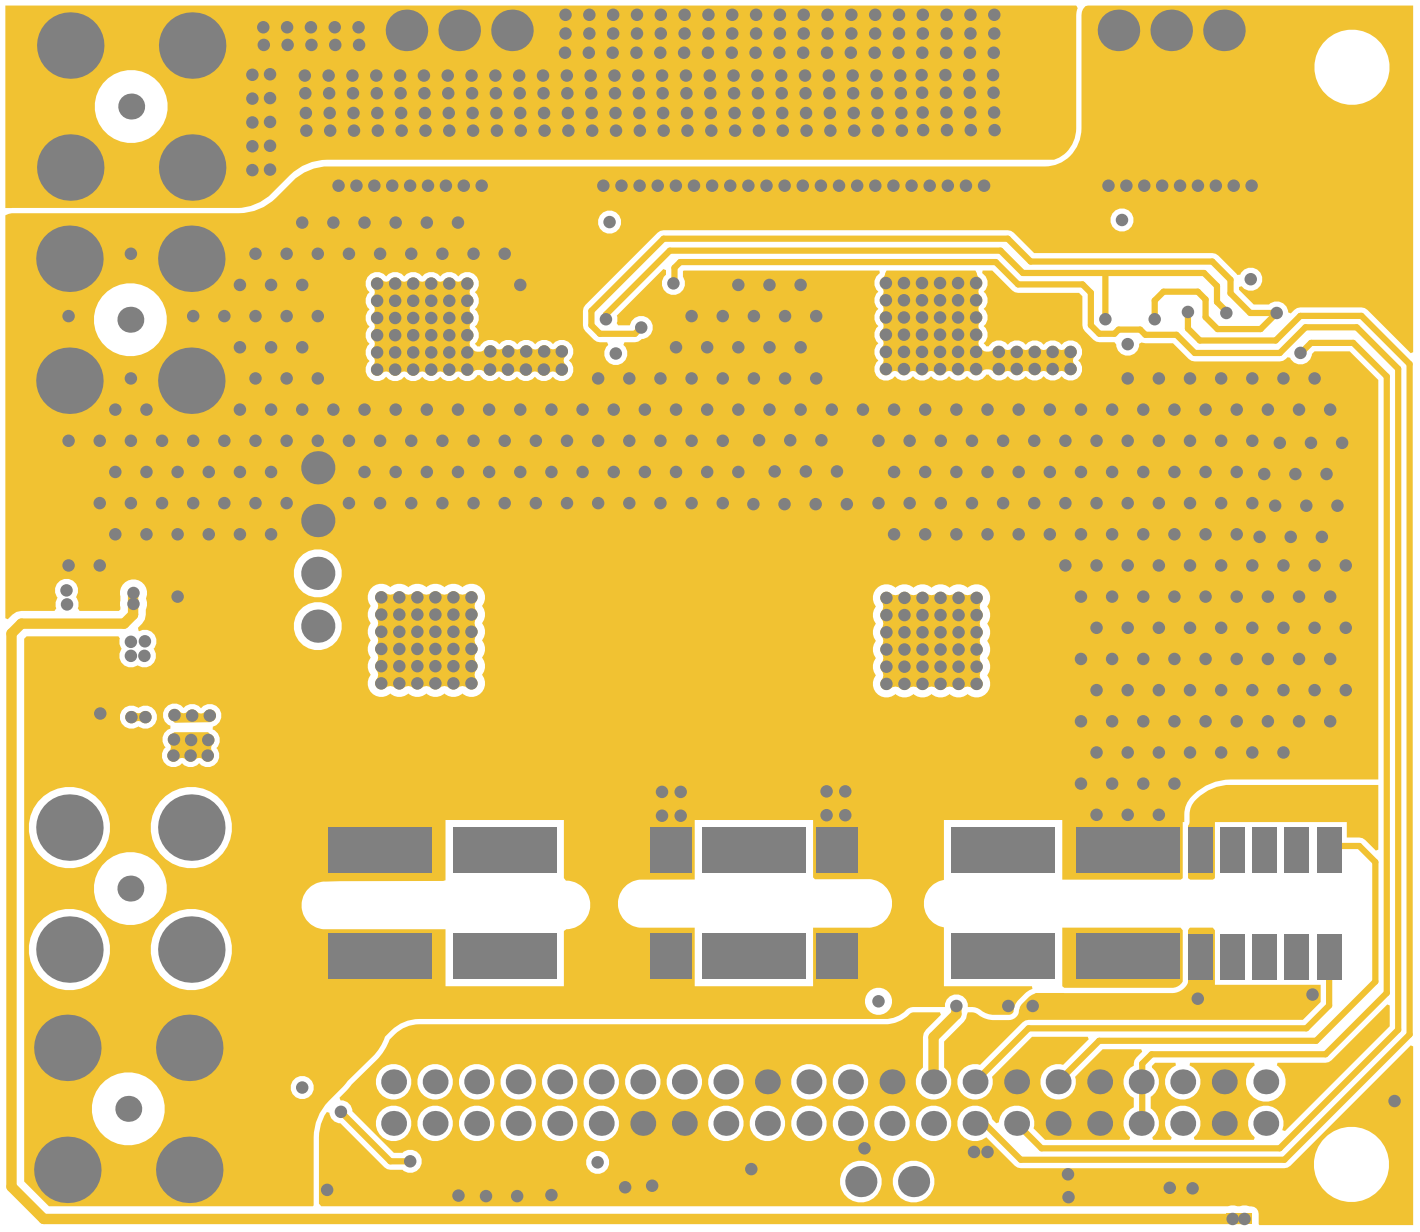
[picture p24: page 2]

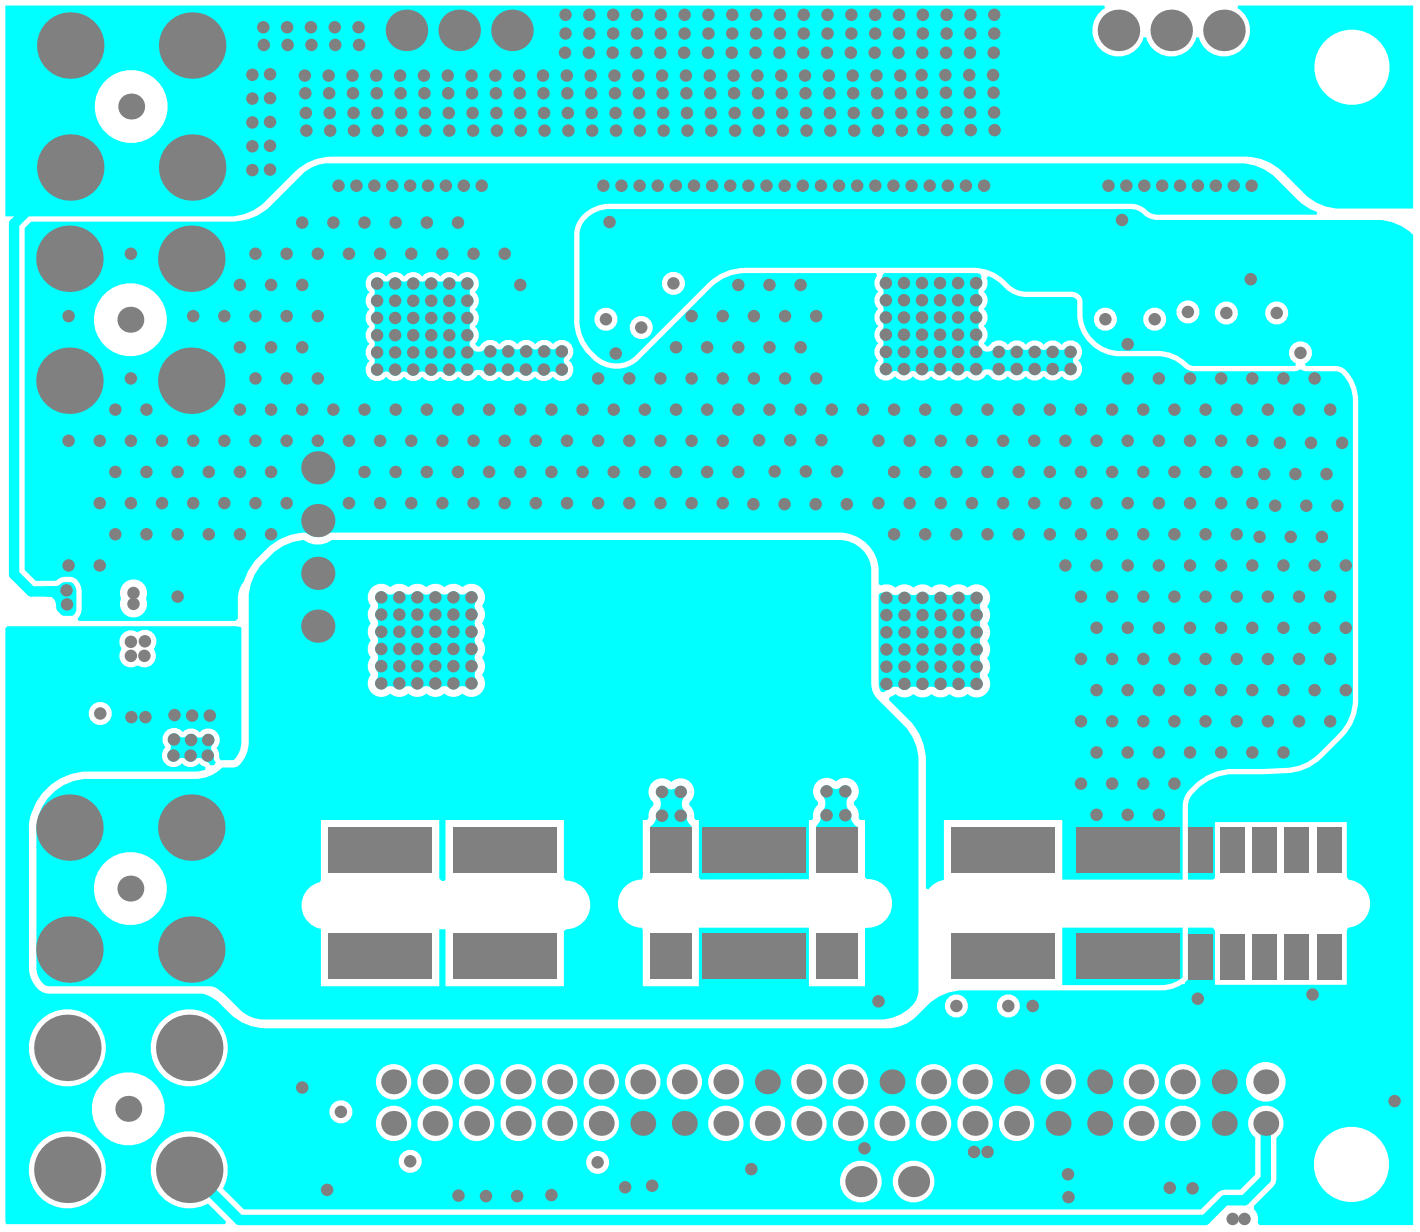
[picture p25: page 3]

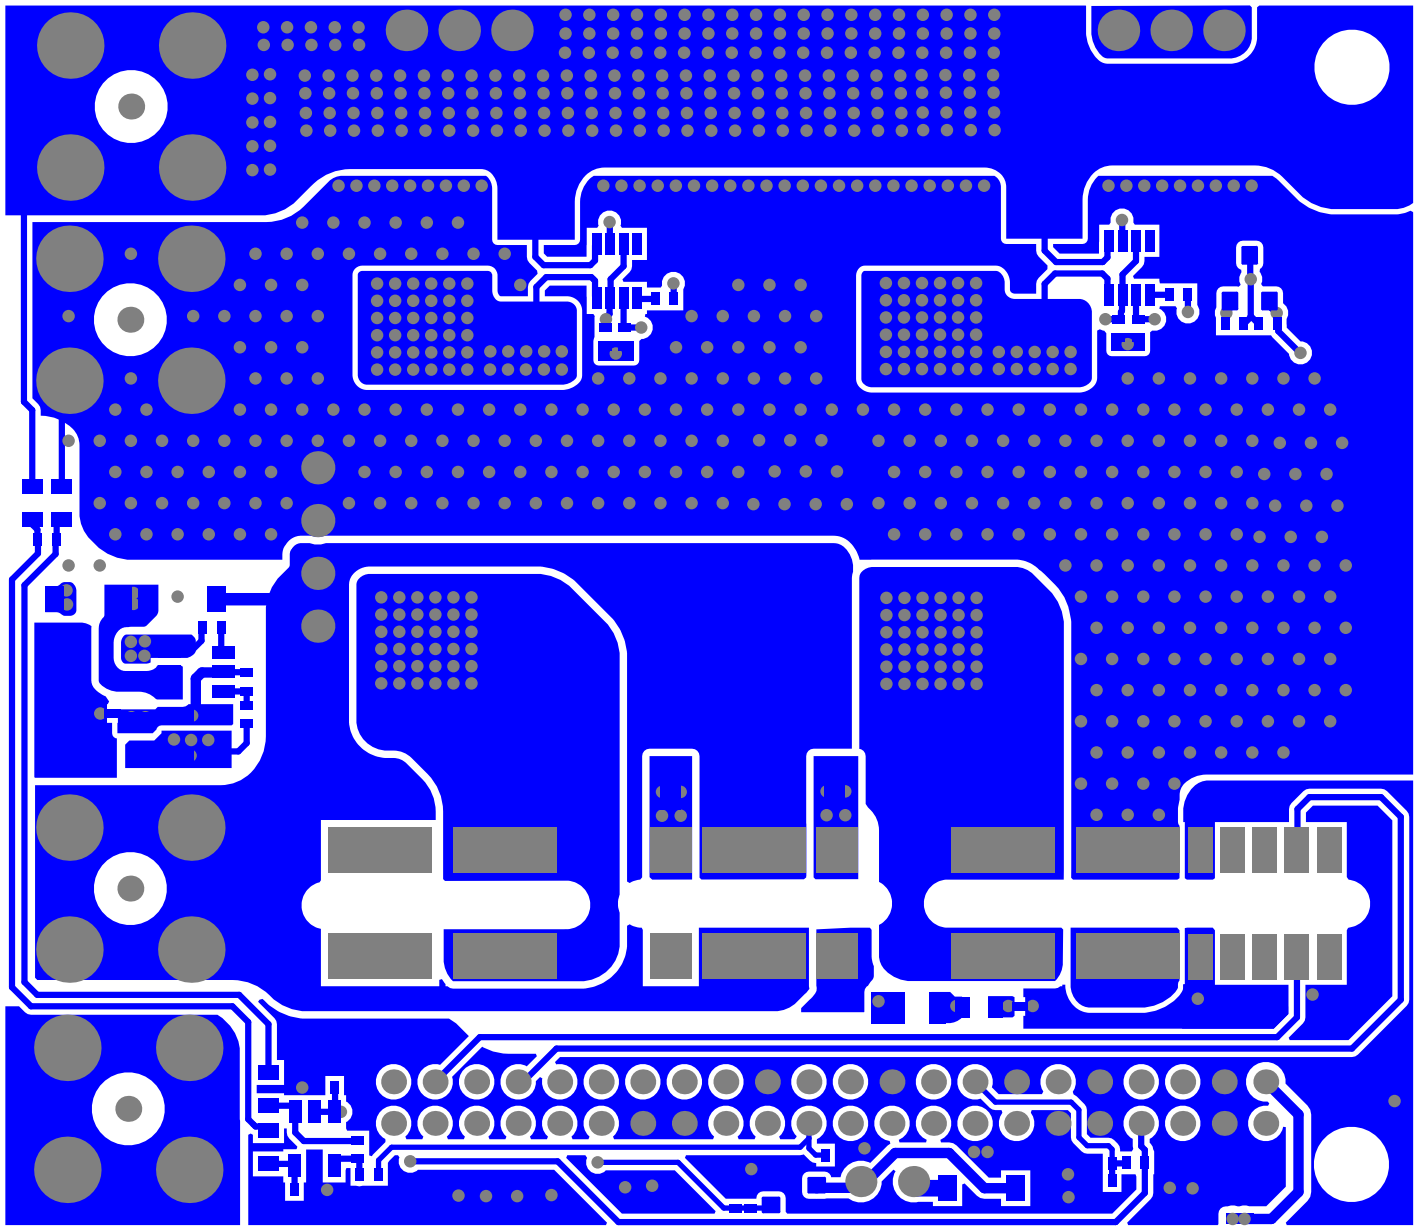
[picture p26: page 4]
