TeoMouse/2P2S3B-Converter/2_Schematic_Documents/4_InputCapBoard/PCB_Layers.PDF

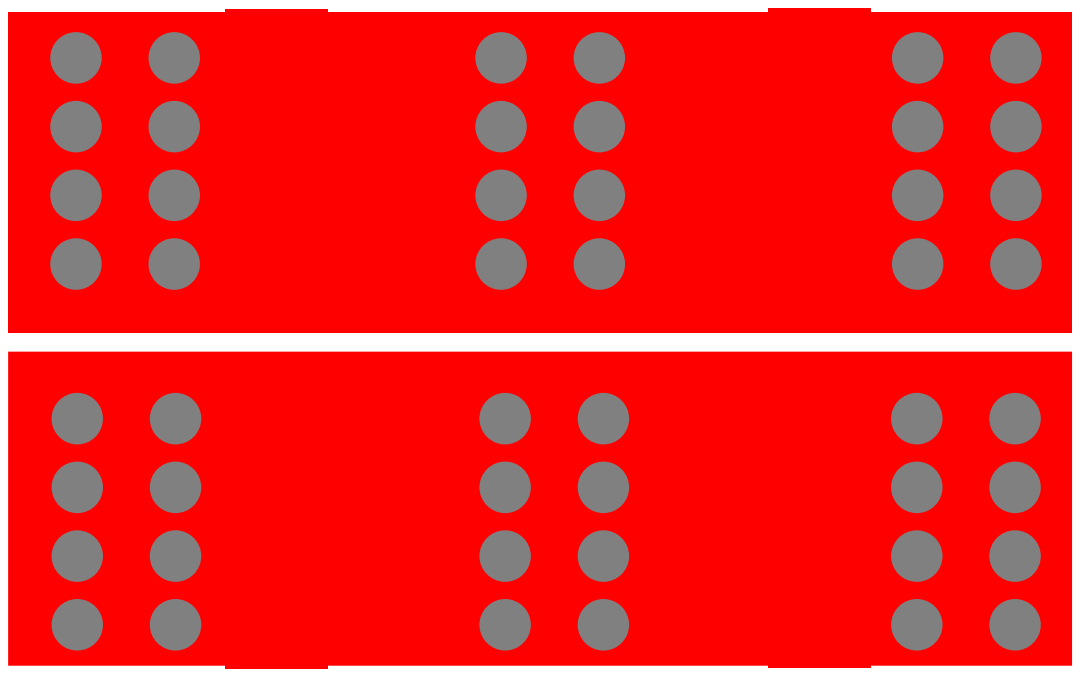
[picture p27: page 1]

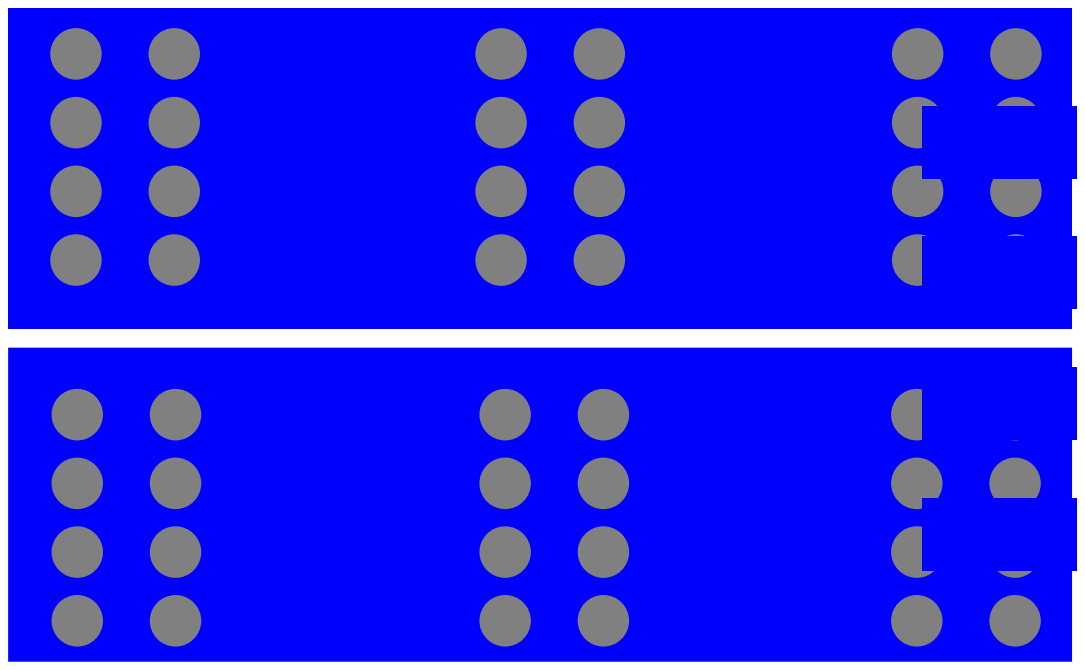
[picture p28: page 4]
