TeoMouse/2P2S3B-Converter/2_Schematic_Documents/4_InputCapBoard/Schematics.PDF

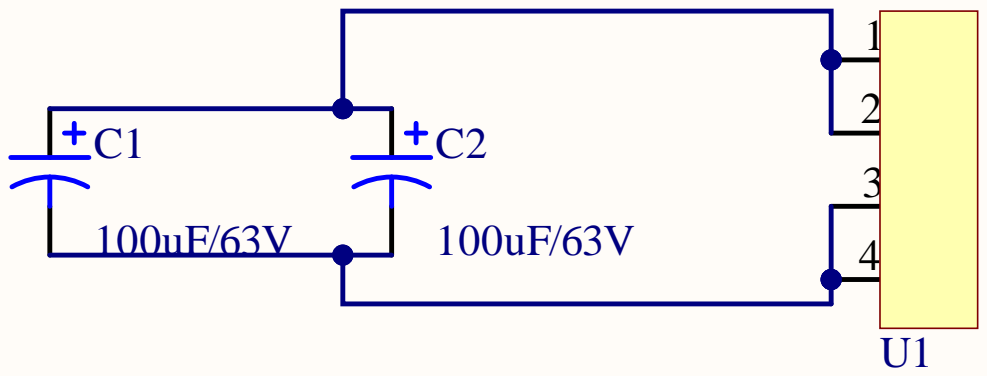
[picture p29: page 1]
