TeoMouse/2P2S3B-Converter/2_Schematic_Documents/5_OutputCapBoard/PCB_Layers.PDF

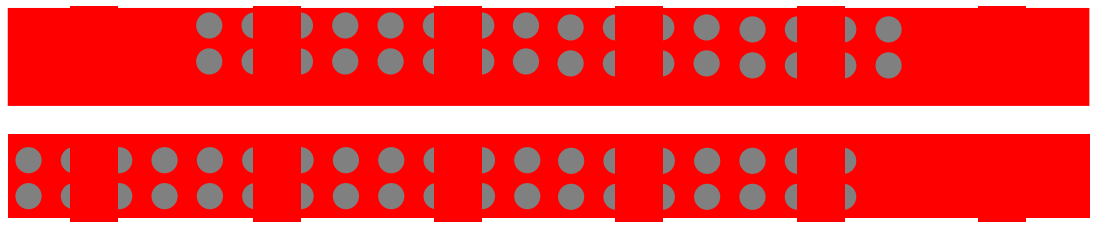
[picture p30: page 1]

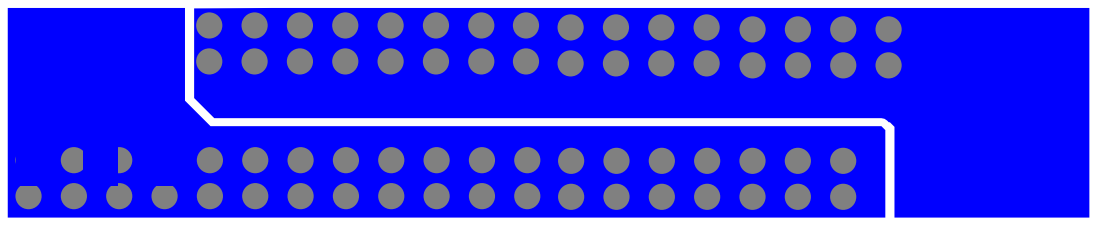
[picture p31: page 4]
