TeoMouse/2P2S3B-Converter/2_Schematic_Documents/5_OutputCapBoard/Schematics.PDF

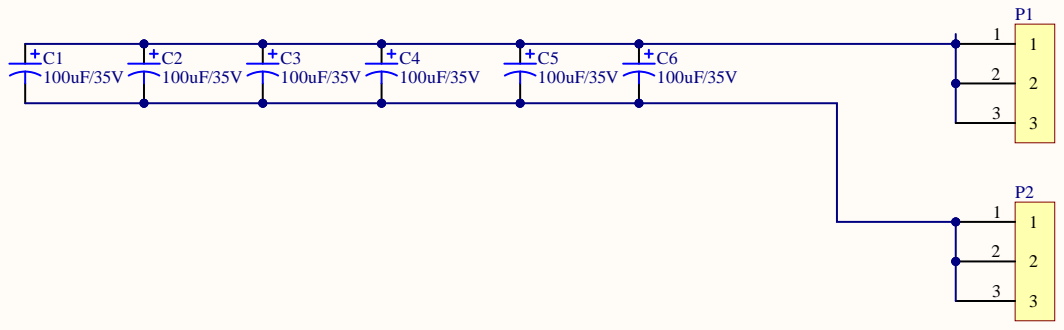
[picture p32: page 1]
