TeoMouse/2P2S3B-Converter/(commit log)

2025-03-23 Ram Files plus cmd files
    [adc (1).obj, adc (2).obj, adc.obj, control (2).obj, control.obj, f28002x_codestartbranch.obj, f28002x_cputimers.obj, f28002x_defaultisr.obj]
2025-03-23 Schematic Documents and layout documents
2025-03-23 Gerber Files, NC drill Files, BOM, and step file for every board
    [Bill of Materials-2Ph_BuckBoost_Main.xlsx, Bill of Materials-Cap_Board.xlsx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]
2025-03-23 Test report and operation off the converter
    [2SWBB_Test_Report_BuckMode.xlsx]
